rajatchaple/cubit_3.0/misc/lcd_screens_builder/cubit3/screen_images/about_image_saloni.png

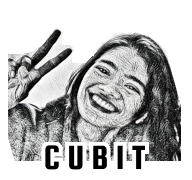
misc/lcd_screens_builder/cubit3/screen_images/about_image_saloni.png
