rajatchaple/cubit_3.0/challenges_faced/iCloud Photos/IMG_4615.JPEG

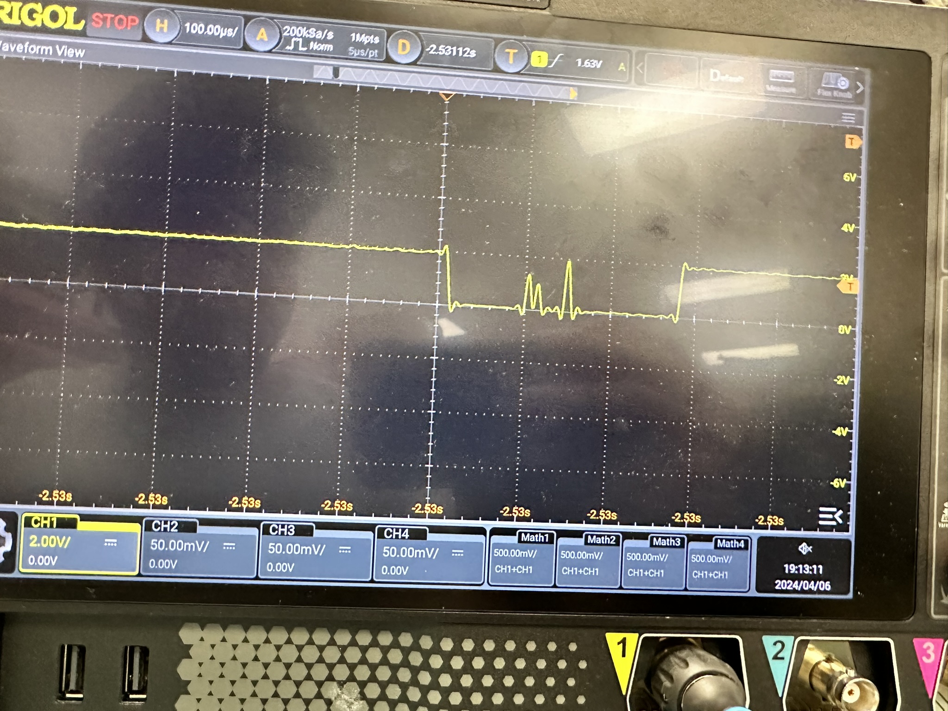
challenges_faced/iCloud Photos/IMG_4615.JPEG
