rajatchaple/cubit_3.0/software/imported_project_report.html

# Project Import Summary

Import time | Apr 2, 2024, 9:28:46 PM
Original location | C:\Users\rajat\OneDrive\Low Power\cubit2.0\lpedt_cubit_2.0\software\.cproject
Original project name | software
Original project type | Simplicity Studio (.sls)
Import mode | Copy contents
