rajatchaple/cubit_3.0/challenges_faced/iCloud Photos/IMG_4606.JPEG

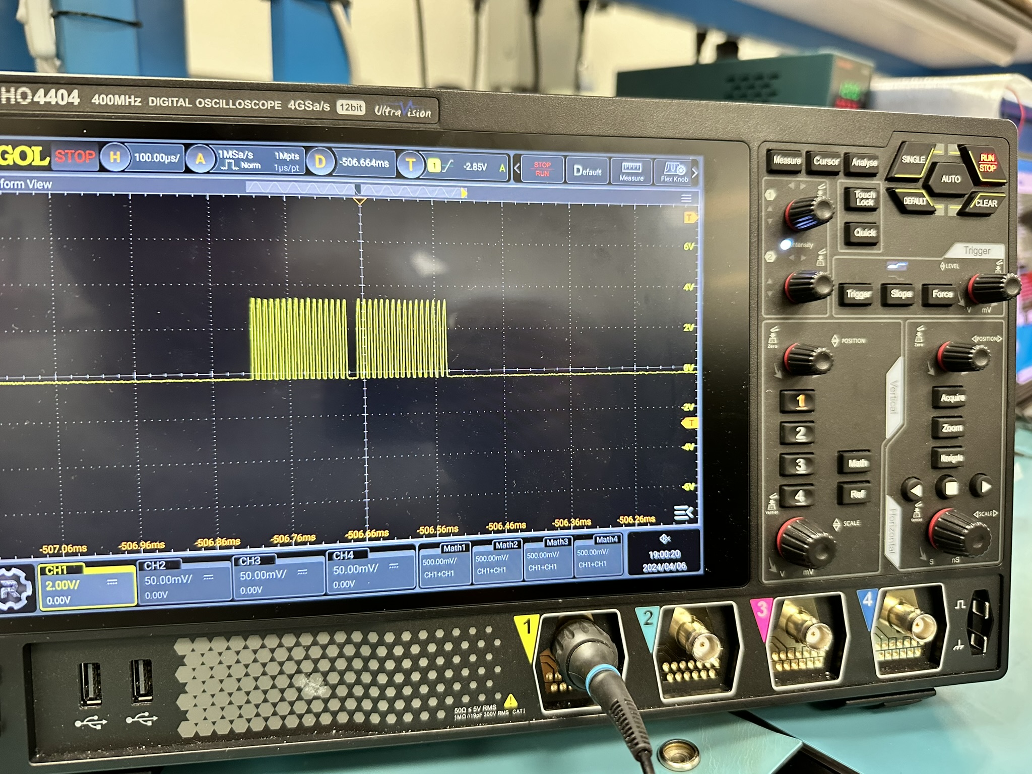
challenges_faced/iCloud Photos/IMG_4606.JPEG
