rajatchaple/cubit_3.0/challenges_faced/iCloud Photos/IMG_4608.JPEG

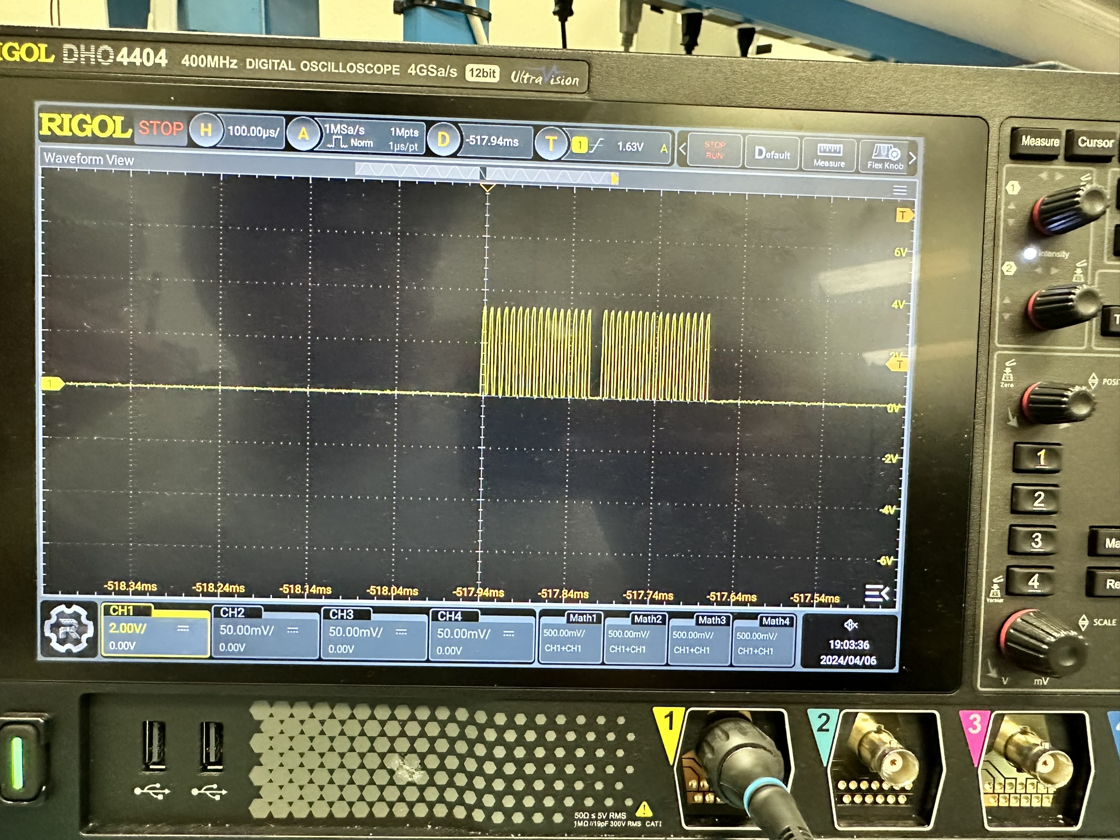
challenges_faced/iCloud Photos/IMG_4608.JPEG
