rajatchaple/cubit_3.0/challenges_faced/iCloud Photos/IMG_4609.JPEG

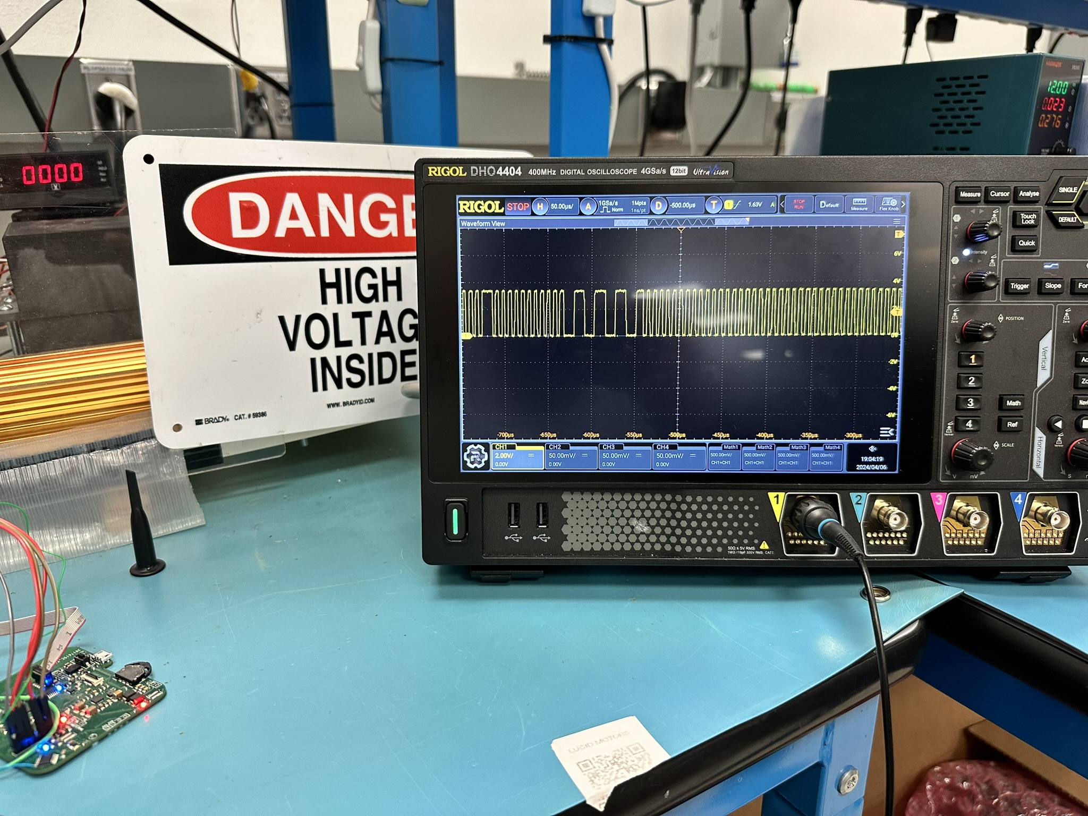
challenges_faced/iCloud Photos/IMG_4609.JPEG
