rajatchaple/cubit_3.0/challenges_faced/iCloud Photos/IMG_4610.JPEG

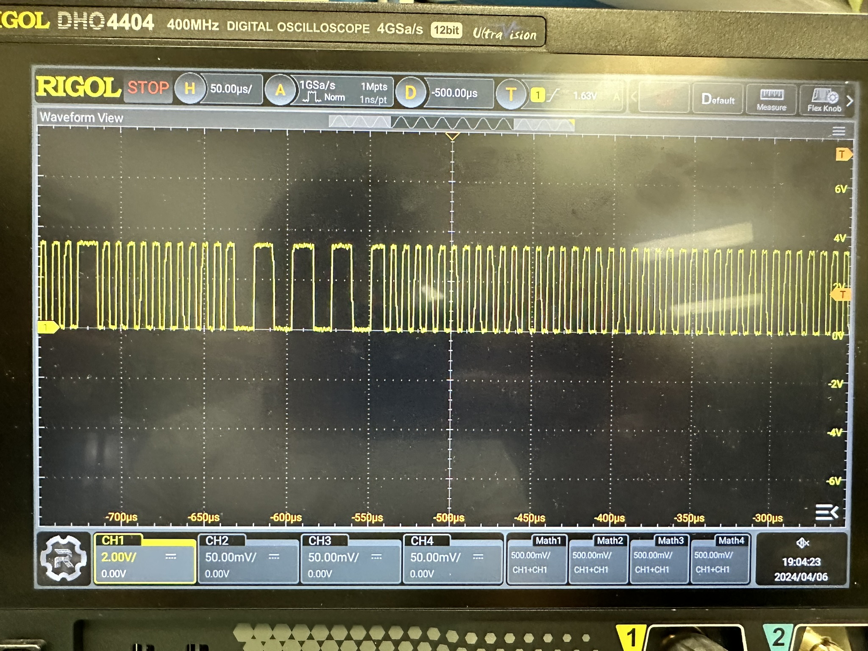
challenges_faced/iCloud Photos/IMG_4610.JPEG
