rajatchaple/cubit_3.0/pcb/components_list.pdf

Designator | Comment | Description | Footprint | Qty
C1, C14, C16, C17 | 1uF 25V | Cap 1 µF ±10% 25V Ceramic Capacitor X5R 0805 (2012 Metric) CAP_0805_02X125 | | 4
C2, C15, C20, C23, C29, C30, C31, C32, C36, C37, C40, C42 0.1uF 16V | | Cap Ceramic 0.1uF 16V X7R 10% SMD 0603 125°C Paper T/R CAP_0603_1MM | | 12
C3, C4, C5 | 1nF 50V | 1nF ±10% 50V X7R 0805 | CAP_0805_02X125 | 3
C6, C13, C18, C25, C33, C34, C35, C38, C39, C41 10uF 25V | | Cap 0805 25 V 10 uF ±20% Tolerance X5R Monolithic Ceramic Chip Capacitor CAP_0805_02X125 | | 10
C7 | 1.5pF 50V | Cap Ceramic 1.5pF 50V C0G 5% Pad SMD 0402 125C Automotive T/R CAP_0402_1mm | | 1
C8 | 100pF 50V | Cap 0.1nF ±10% 50V X7R 0805 CAP_0805_02X125 | | 1
C9, C11 | 10pF 50V | Cap Ceramic 10pF 50V X7R 10% SMD 0805 125°C Paper T/R CAP_0805_02X125 | | 2
C10 | 220nF 50V | Cap 220nF ±10% 50V X7R 0805 CAP_0805_02X125 | | 1
C12, C22, C26 | 4.7uF 10V | Cap CL10 Series 4.7 uF 10 V ±10 % Tolerance X5R SMT Multilayer Ceramic Capacitor CAP_0603_1MM | | 3
C19, C27 | 10nF 50V | Cap 10nF ±10% 50V X7R 0805 CAP_0805_02X125 | | 2
C21 | 220uF 6.3V | Cap 220uF 6.3volts X5R 20%Chip_1210_3.2x2.5 | | 1
C24, C28 | 100uF 10V | Cap 100uF ±20% 10V X5R 1210 Chip_1210_3.2x2.5 | | 2
D1, D2 | Schottky Diode | LSM115J Series 15 V 1 A Surface Mount Schottky Rectifier - DO-214BA SCHOTTKY4336X33N | | 2
H1 | Debug Port | CONN HEADER SMD 10POS 1.27MM. Connector Header Surface Mount 10 position 0.050" Amphenol_20021121_0 | | 1
H2 | Battery Connector | 2.00mm Pitch Mi ll System Wire-to-Board Header, Surface Mount, Single Row, Vertical, 2 Circuits BAT_CONN | | 1
H3 | USB MICRO B RECPT | USB - micro B USB 2.0 Receptacle Connector 5 Position Surface Mount, Right Angle; Through Hole MICROUSB_AMPHENOL_10118194-0001LF 1
H4 | PREC003SAAN-RC | Connector Header Through Hole 3 position 0.100" (2.54mm) 3_PIN_100mil | | 1
H5, H6 | External Power Connector | | 2_PIN_100mil | 2
H7 | SPI_MAG | | 6_PIN_100MIL | 1
H8 | Laser connector | 2.00mm Pitch | BAT_CONN | 1
L1, L2 | 1.9nH 1A | Inductor Chip 1.9nH 0.3nH Tolerance 2-Pin 0402 Paper T/R CAP_0402_1mm | | 2
L3, L4 | 600ohm 500mA | Ferrite Beads 0603 600Ω ±25% DCR=0.38Ω 500mA IND_FERRITE_0603_1.6x0.4 | | 2
L5 | 4.7uH 1.4A | 4.7uH, 20%, 1 Element, Metal Alloy-Core, SMD, 1008 INDP2523X23N_4u7 | | 1
L6 | 1k 200mA | Ferrite Beads WE-CBF 0603 SMD Bead 100MHz 1000Ohm 200mA CAP_0603_1MM | | 1
L7 | 22uH | Inductor Power Shielded Wirewound 22uH 20% 1MHz Ferrite 0.87A 0.496Ohm DCR 1212 T/R 2_IND_3x3 | | 1
L8 | 10uH 1A | Inductor Power Shielded Multi-Layer 10uH 20% 1MHz Metal 0.85A 0.46Ohm DCR 1008 T/R 2_chip_2.5x2 | | 1
LCD1 | 505110-1092_SHARP_LCDFFC/FPC Connector, 10 Contact(s), 1 Row(s), Female, Right Angle, Surface Mount Terminal SHARP_LCD | | | 1
LED4, LED10 | Green | Led Green Clear 0603 SMDLED_0603_RED_WL-SMCW | | 2
LED5, LED6, LED7, LED8 150060RS75000 | | LED Low-Power Uni-Color Red 630nm 2V 2-Pin Chip 0603(1608Metric) T/R LED_0603_RED_WL-SMCW | | 4
LED11, LED12 | 150060BS75000 | Led, Blue, 470 Nm, 3.2 V, 30 Ma, 145 Mcd Rohs Compliant: Yes LED_0603_RED_WL-SMCW | | 2
MH1, MH3, MH6, MH7, MH8, MH16 #4_Hole | | | HOLE_#4 | 6
R1, R7, R8 | 10k 1% | Res 10K Ohm 1% 1/10W ±100ppm/°C Molded SMD SMD Paper T/R 2_Chip_0603_RMCF | | 3
R2, R3, R5, R6 | 1M 1% | Res 1M Ohm 1% 1/10W ±100ppm/°C Molded SMD Paper T/R 2_Chip_0603_RMCF | | 4
R4, R18 | 100 1% | Res 100 Ohm 1% 1/10W ±100ppm/°C Molded SMD SMD Paper T/R 2_Chip_0603_RMCF | | 2
R10, R11 | 4.7k 1% | Res Thick Film 0603 4.7K Ohm 1% 1/10W ±100ppm/°C Molded SMD Paper T/R CAP_0603_1MM | | 2
R12, R13, R21 | 0 5% | Res 0 Ohms ±5% 0.063 W 0402 Thick Film Surface Mount Chip Resistor CAP_0402_1mm | | 3
R16, R26, R27, R31, R38 | 1k 1% | Res 1K Ohm 1% 0.1W(1/10W) ±100ppm/C Pad SMD Automotive T/R 2_Chip_0603_RMCF | | 5
R17, R25 | 1 1% | Res 1 Ohm 1% 1/10W ±200ppm/°C Molded SMD SMD Paper T/R CAP_0603_1MM | | 2
R19 | 10M 1% | Res 10M Ohm 1% 1/10W ±200ppm/°C Molded SMD SMD Paper T/R 2_Chip_0603_RMCF | | 1
R20 | 2M 1% | RES 2M OHM 1% 1/10W 0603 2_Chip_0603_RMCF | | 1
R22 | 7.87M 1% | Res 7.87M Ohm 1% 1/10W ±200ppm/°C Molded SMD SMD Paper T/R 2_Chip_0603_RMCF | | 1
R23 | 20 1% | Res High Voltage 0603 20 Ohm 1/10W 1% SMD 2_Chip_0603_RMCF | | 1
R28, R33 | 7.32M 1% | Res 7.32M Ohm 1% 1/10W ±200ppm/°C Molded SMD SMD Paper T/R 2_Chip_0603_RMCF | | 2

Designator | Comment | Description | Footprint | Qty
R29 | 1.43M 1% | Res 1.43M Ohm 1% 1/10W ±200ppm/°C Molded SMD SMD Paper T/R 2_Chip_0603_RMCF | | 1
R30 | 8.06M 1% | Res 8.06M Ohm 1% 1/10W ±200ppm/°C Molded SMD SMD Paper T/R 2_Chip_0603_RMCF | | 1
R32 | 5.62M 1% | Res 5.62M Ohm 1% 1/10W ±200ppm/°C Molded SMD SMD Paper T/R 2_Chip_0603_RMCF | | 1
R34 | 4.87M 1% | Res 4.87M Ohm 1% 1/10W ±200ppm/°C Molded SMD SMD Paper T/R 2_Chip_0603_RMCF | | 1
R35 | 3k 1% | Res 3000Ω ± 1.00% 0.1W ± 100ppm/ CAP_0603_1MM | | 1
R36 | 4.42M 1% | Res 4.42M Ohm 1% 1/10W ±200ppm/°C Molded SMD SMD Paper T/R 2_Chip_0603_RMCF | | 1
R40, R42 | 3kohm | Res 3000Ω ± 1.00% 0.1W ± 100ppm/ CAP_0603_1MM | | 2
S1, S2, S3, S4, S5, S6, S7, S8, S9, S10 Solar Cell | | Monocrystalline SOLAR CELL 30.7MW 690MV KXOB25-14X1F | | 10
SW1 | COM-08184 | Surface Mount Navigation Switch Navigation_switch | | 1
SW2 | Switch | Keypad Switch, 1 Switches, SPST, Momentary-tactile, 0.05A, 12VDC, 1.77N, Solder Terminal, Surface Mount-straight Reset Sw | | 1
TP6 | 3_pin_test | | 3_PIN_100mil | 1
U1 | Analog Switch | SPDT, 2 Func, 2 Channel, PDSO10 TSSOP50P490X110-10N | | 1
U2, U8, U12, U13 | Load SW | 5.5-V, 0.1-A, 500-mΩ, load switch with current limit and active low enable 5-SC70 -40 to 85 SOT65P210X110-5N | | 4
U3 | EFR32BG13 | Blue Gecko QFN48 2.4 G 19 dB BLE/Proprietary 512 kB 64 kB(RAM) 31GPIO 48-QFN_7x7 | | 1
U4, U5 | ESD-SP1003 | TVS DIODE 5VWM 12VC SOD723 Littelfuse_Inc_SP1003_MFG | | 2
U6 | BQ25570 | Switching Battery Charger Li-Ion/Li-Pol/Supercapacitor 110mA 2.2V to 5.5V 20-Pin VQFN EP T/R 21_QFN_35x35 | | 1
U7 | Ultrasonic Sensor | | 4_PIN_ultrasonic_sensor | 1
U9 | BNO005 | | LGA28R50P4X10_380X520X100 1
U10, U11 | AS5047D-ATSM | | 14-TSOP_5x4_4 | 2
U14 | BATT Monitor IC | Battery Battery Monitor IC Lithium-Ion 8-TDFN-EP ( MAX17048 | | 1
X1 | 38.4MHz | Crystal 38.4000MHZ 10PF SMD OSC_38.4MHz | | 1
Y1 | ECS-.327-7-34B-TR | 32.768kHz Â±20ppm Crystal 7pF 70 kOhms 2-SMD, No Lead XTAL_ECS-.327-7-34B-TR | | 1
