rajatchaple/cubit_3.0/pcb/BOM_cubit2.xlsx

Comment | Description | Designator | Footprint | LibRef | Quantity | Case/Package | Manufacturer | Manufacturer Part Number | Supplier 1
1uF 25V | Cap 1 µF ±10% 25V Ceramic Capacitor X5R 0805 (2012 Metric) | C1, C14, C16, C17 | CAP_0805_02X125 | GRM216R61E105KA12D | 4 | 0805 | Murata | GRM216R61E105KA12D | Digi-Key
0.1uF 16V | Cap Ceramic 0.1uF 16V X7R 10% SMD 0603 125°C Paper T/R | C2, C15, C20, C23, C29, C30, C31, C32, C36, C37, C40, C42 | CAP_0603_1MM | C0805C104K4RACAUTO | 12 | 0805 | KEMET | C0805C104K4RACAUTO | Digi-Key
1nF 50V | 1nF ±10% 50V X7R 0805 | C3, C4, C5 | CAP_0805_02X125 | CL21B102KBANFNC | 3 | 0805 | Samsung | CL21B102KBANFNC | Digi-Key
10uF 25V | Cap 0805 25 V 10 uF ±20% Tolerance X5R Monolithic Ceramic Chip Capacitor | C6, C13, C18, C25, C33, C34, C35, C38, C39, C41 | CAP_0805_02X125 | GRM21BR61E106KA73K | 10 | 0805 | Murata | GRM21BR61E106KA73K | Digi-Key
1.5pF 50V | Cap Ceramic 1.5pF 50V C0G 5% Pad SMD 0402 125C Automotive T/R | C7 | CAP_0402_1mm | GCM1555C1H1R5JA16D | 1 | 0402 | Murata | GCM1555C1H1R5JA16D | Digi-Key
100pF 50V | Cap 0.1nF ±10% 50V X7R 0805 | C8 | CAP_0805_02X125 | CC0805KRX7R9BB101 | 1 | 0805 | Yageo | CC0805KRX7R9BB101 | Digi-Key
10pF 50V | Cap Ceramic 10pF 50V X7R 10% SMD 0805 125°C Paper T/R | C9, C11 | CAP_0805_02X125 | C0805C100K5RACTU | 2 | 0805 | KEMET | C0805C100K5RACTU | Digi-Key
220nF 50V | Cap 220nF ±10% 50V X7R 0805 | C10 | CAP_0805_02X125 | CC0805KKX7R9BB224 | 1 | 0805 | Yageo | CC0805KKX7R9BB224 | Digi-Key
4.7uF 10V | Cap CL10 Series 4.7 uF 10 V ±10 % Tolerance X5R SMT Multilayer Ceramic Capacitor | C12, C22, C26 | CAP_0603_1MM | CL10A475KP8NNNC | 3 | 0603 | Samsung | CL10A475KP8NNNC | Digi-Key
10nF 50V | Cap 10nF ±10% 50V X7R 0805 | C19, C27 | CAP_0805_02X125 | CL21B103KBCNNNC | 2 | 0805 | Samsung | CL21B103KBCNNNC | Digi-Key
220uF 6.3V | Cap 220uF 6.3volts X5R 20% | C21 | Chip_1210_3.2x2.5 | GRM32ER60J227ME05L | 1 |  | Murata | GRM32ER60J227ME05L | Digi-Key
100uF 10V | Cap 100uF ±20% 10V X5R 1210 | C24, C28 | Chip_1210_3.2x2.5 | CL32A107MPVNNNE | 2 | 1210 | Samsung | CL32A107MPVNNNE | Digi-Key
Schottky Diode | LSM115J Series 15 V 1 A Surface Mount Schottky Rectifier - DO-214BA | D1, D2 | SCHOTTKY4336X33N | LSM115JE3/TR13 | 2 |  | Microchip | LSM115JE3/TR13 | Digi-Key
Debug Port | CONN HEADER SMD 10POS 1.27MM. Connector Header Surface Mount 10 position 0.050" | H1 | Amphenol_20021121_0 | 20021121-00010C1LF | 1 |  | Amphenol ICC / FCI | 20021121-00010C1LF | Digi-Key
Battery Connector | 2.00mm Pitch Mi ll System Wire-to-Board Header, Surface Mount, Single Row, Vertical, 2 Circuits | H2 | BAT_CONN | 0554600272 | 1 |  | Molex | 0554600272 | Digi-Key
USB MICRO B RECPT | USB - micro B USB 2.0 Receptacle Connector 5 Position Surface Mount, Right Angle; Through Hole | H3 | MICROUSB_AMPHENOL_10118194-0001LF | 10118194-0001LF | 1 |  | Amphenol FCI | 10118194-0001LF | Digi-Key
PREC003SAAN-RC | Connector Header Through Hole 3 position 0.100" (2.54mm) | H4 | 3_PIN_100mil | SW_3Pin_100mil_Switch | 1
External Power Connector |  | H5, H6 | 2_PIN_100mil | ext_pwr_conn | 2
SPI_MAG |  | H7 | 6_PIN_100MIL | 6_pin_connector | 1
Laser connector | 2.00mm Pitch | H8 | BAT_CONN | batt_conn_pad | 1
1.9nH 1A | Inductor Chip 1.9nH 0.3nH Tolerance 2-Pin 0402 Paper T/R | L1, L2 | CAP_0402_1mm | LQG15WZ1N9S02D | 2 |  | Murata | LQG15WZ1N9S02D | Digi-Key
600ohm 500mA | Ferrite Beads 0603 600Ω ±25% DCR=0.38Ω 500mA | L3, L4 | IND_FERRITE_0603_1.6x0.4 | BLM18AG601SN1D | 2 | 0603 | Murata | BLM18AG601SN1D | Digi-Key
4.7uH 1.4A | 4.7uH, 20%, 1 Element, Metal Alloy-Core, SMD, 1008 | L5 | INDP2523X23N_4u7 | DFE252012P-4R7M=P2 | 1 |  | Murata | DFE252012P-4R7M=P2 | Digikey
1k 200mA | Ferrite Beads WE-CBF 0603 SMD Bead 100MHz 1000Ohm 200mA | L6 | CAP_0603_1MM | 74279266 | 1 | SMD/SMT | Wurth Electronics | 74279266 | Digi-Key
22uH | Inductor Power Shielded Wirewound 22uH 20% 1MHz Ferrite 0.87A 0.496Ohm DCR 1212 T/R | L7 | 2_IND_3x3 | VLS3015CX-220M-1 | 1 |  | TDK | VLS3015CX-220M-1 | Digi-Key
10uH 1A | Inductor Power Shielded Multi-Layer 10uH 20% 1MHz Metal 0.85A 0.46Ohm DCR 1008 T/R | L8 | 2_chip_2.5x2 | 1239AS-H-100M=P2 | 1 | 1008 | Murata | 1239AS-H-100M=P2 | Digi-Key
505110-1092_SHARP_LCD | FFC/FPC Connector, 10 Contact(s), 1 Row(s), Female, Right Angle, Surface Mount Terminal | LCD1 | SHARP_LCD | 505110-1092_SHARP_LCD | 1 |  | Molex | 505110-1092 | Digi-Key
Green | Led Green Clear 0603 SMD | LED4, LED10 | LED_0603_RED_WL-SMCW | QBLP601-AG1 | 2 |  | QT-Brightek | QBLP601-AG1 | Digi-Key
150060RS75000 | LED Low-Power Uni-Color Red 630nm 2V 2-Pin Chip 0603(1608Metric) T/R | LED5, LED6, LED7, LED8 | LED_0603_RED_WL-SMCW | 150060RS75000 | 4 | 0603 | Wurth Electronics | 150060RS75000 | Digi-Key
150060BS75000 | Led, Blue, 470 Nm, 3.2 V, 30 Ma, 145 Mcd Rohs Compliant: Yes | LED11, LED12 | LED_0603_RED_WL-SMCW | 150060BS75000 | 2 | 0603 | Wurth Electronics | 150060BS75000 | Digi-Key
#4_Hole |  | MH1, MH3, MH6, MH7, MH8, MH16 | HOLE_#4 | Mechanical_Hole | 6
10k 1% | Res 10K Ohm 1% 1/10W ±100ppm/°C Molded SMD SMD Paper T/R | R1, R7, R8 | 2_Chip_0603_RMCF | RMCF0603FT10K0 | 3 | 0603 | Stackpole Electronics | RMCF0603FT10K0 | Digi-Key
1M 1% | Res 1M Ohm 1% 1/10W ±100ppm/°C Molded SMD Paper T/R | R2, R3, R5, R6 | 2_Chip_0603_RMCF | RMCF0603FT1M00 | 4 | 0603 | Stackpole Electronics | RMCF0603FT1M00 | Digi-Key
100 1% | Res 100 Ohm 1% 1/10W ±100ppm/°C Molded SMD SMD Paper T/R | R4, R18 | 2_Chip_0603_RMCF | RMCF0603FT100R | 2 | 0603 | Stackpole Electronics | RMCF0603FT100R | Digi-Key
4.7k 1% | Res Thick Film 0603 4.7K Ohm 1% 1/10W ±100ppm/°C Molded SMD Paper T/R | R10, R11 | CAP_0603_1MM | AF0603FR-074K7L | 2 | 0603 | Yageo | AF0603FR-074K7L | Digi-Key
0 5% | Res 0 Ohms ±5% 0.063 W 0402 Thick Film Surface Mount Chip Resistor | R12, R13, R21 | CAP_0402_1mm | RC1005J000CS | 3 | 0402 | Samsung | RC1005J000CS | Digi-Key
1k 1% | Res 1K Ohm 1% 0.1W(1/10W) ±100ppm/C Pad SMD Automotive T/R | R16, R26, R27, R31, R38 | 2_Chip_0603_RMCF | RMCF0603FT1K00 | 5 | 0603 | Stackpole Electronics | RMCF0603FT1K00 | Digi-Key
1 1% | Res 1 Ohm 1% 1/10W ±200ppm/°C Molded SMD SMD Paper T/R | R17, R25 | CAP_0603_1MM | RC0603FR-101RL | 2 | 0603 | Yageo | RC0603FR-101RL | Digi-Key
10M 1% | Res 10M Ohm 1% 1/10W ±200ppm/°C Molded SMD SMD Paper T/R | R19 | 2_Chip_0603_RMCF | RMCF0603FT10M0 | 1 | 0603 | Stackpole Electronics | RMCF0603FT10M0 | Digi-Key
2M 1% | RES 2M OHM 1% 1/10W 0603 | R20 | 2_Chip_0603_RMCF | RMCF0603FT2M00 | 1 | 0603 | Stackpole Electronics | RMCF0603FT2M00 | Digi-Key
7.87M 1% | Res 7.87M Ohm 1% 1/10W ±200ppm/°C Molded SMD SMD Paper T/R | R22 | 2_Chip_0603_RMCF | RMCF0603FT7M87 | 1 | 0603 | Stackpole Electronics | RMCF0603FT7M87 | Digi-Key
20 1% | Res High Voltage 0603 20 Ohm 1/10W 1% SMD | R23 | 2_Chip_0603_RMCF | KTR03EZPF20R0 | 1 | 0603 | Rohm | KTR03EZPF20R0 | Digi-Key
7.32M 1% | Res 7.32M Ohm 1% 1/10W ±200ppm/°C Molded SMD SMD Paper T/R | R28, R33 | 2_Chip_0603_RMCF | RMCF0603FT7M32 | 2 | 0603 | Stackpole Electronics | RMCF0603FT7M32 | Digi-Key
1.43M 1% | Res 1.43M Ohm 1% 1/10W ±200ppm/°C Molded SMD SMD Paper T/R | R29 | 2_Chip_0603_RMCF | RMCF0603FT1M43 | 1 | 0603 | Stackpole Electronics | RMCF0603FT1M43 | Digi-Key
8.06M 1% | Res 8.06M Ohm 1% 1/10W ±200ppm/°C Molded SMD SMD Paper T/R | R30 | 2_Chip_0603_RMCF | RMCF0603FT8M06 | 1 | 0603 | Stackpole Electronics | RMCF0603FT8M06 | Digi-Key
5.62M 1% | Res 5.62M Ohm 1% 1/10W ±200ppm/°C Molded SMD SMD Paper T/R | R32 | 2_Chip_0603_RMCF | RMCF0603FT5M62 | 1 | 0603 | Stackpole Electronics | RMCF0603FT5M62 | Digi-Key
4.87M 1% | Res 4.87M Ohm 1% 1/10W ±200ppm/°C Molded SMD SMD Paper T/R | R34 | 2_Chip_0603_RMCF | RMCF0603FT4M87 | 1 | 0603 | Stackpole Electronics | RMCF0603FT4M87 | Digi-Key
3k 1% | Res 3000Ω ± 1.00% 0.1W ± 100ppm/℃ 0603 | R35 | CAP_0603_1MM | RC0603FR-073KL | 1 | 0603 | Yageo | RC0603FR-073KL | Digi-Key
4.42M 1% | Res 4.42M Ohm 1% 1/10W ±200ppm/°C Molded SMD SMD Paper T/R | R36 | 2_Chip_0603_RMCF | RMCF0603FT4M42 | 1 | 0603 | Stackpole Electronics | RMCF0603FT4M42 | Digi-Key
3kohm | Res 3000Ω ± 1.00% 0.1W ± 100ppm/℃ 0603 | R40, R42 | CAP_0603_1MM | RC0603FR-073KL | 2 | 0603 | Yageo | RC0603FR-073KL | Digi-Key
Solar Cell | Monocrystalline SOLAR CELL 30.7MW 690MV | S1, S2, S3, S4, S5, S6, S7, S8, S9, S10 | KXOB25-14X1F | KXOB25-14X1F | 10 |  | ANYSOLAR | KXOB25-14X1F-TR | Digikey
COM-08184 | Surface Mount Navigation Switch | SW1 | Navigation_switch | COM-08184 | 1 |  | SparkFun | COM-08184 | Digikey
Switch | Keypad Switch, 1 Switches, SPST, Momentary-tactile, 0.05A, 12VDC, 1.77N, Solder Terminal, Surface Mount-straight | SW2 | Reset Sw | PTS636SL43SMTRLFS | 1 |  | ITT C&K | PTS636SL43SMTRLFS | Digikey
3_pin_test |  | TP6 | 3_PIN_100mil | 3_pin_test | 1
Analog Switch | SPDT, 2 Func, 2 Channel, PDSO10 | U1 | TSSOP50P490X110-10N | TS3A24159DGSR | 1 |  | Texas Instruments | TS3A24159DGSR | Digikey
Load SW | 5.5-V, 0.1-A, 500-mΩ, load switch with current limit and active low enable 5-SC70 -40 to 85 | U2, U8, U12, U13 | SOT65P210X110-5N | TPS22942DCKR | 4 | SC | Texas Instruments | TPS22942DCKR | Digi-Key
EFR32BG13 | Blue Gecko QFN48 2.4 G 19 dB BLE/Proprietary 512 kB 64 kB(RAM) 31GPIO | U3 | 48-QFN_7x7 | EFR32BG13P732F512GM48-D | 1 |  | Silicon Labs | EFR32BG13P732F512GM48-D | Digi-Key
ESD-SP1003 | TVS DIODE 5VWM 12VC SOD723 | U4, U5 | Littelfuse_Inc_SP1003_MFG | SP1003-01DTG | 2 |  | Littelfuse | SP1003-01DTG | Digi-Key
BQ25570 | Switching Battery Charger Li-Ion/Li-Pol/Supercapacitor 110mA 2.2V to 5.5V 20-Pin VQFN EP T/R | U6 | 21_QFN_35x35 | BQ25570RGRT | 1 | VQFN | Texas Instruments | BQ25570RGRT | Digi-Key
Ultrasonic Sensor |  | U7 | 4_PIN_ultrasonic_sensor | Ultrasonic Sensor | 1
BNO005 |  | U9 | LGA28R50P4X10_380X520X100 | BNO055 | 1
AS5047D-ATSM |  | U10, U11 | 14-TSOP_5x4_4 | AS5047D-ATSM | 2 |  | Osram | AS5047D-ATSM | Digi-Key
BATT Monitor IC | Battery Battery Monitor IC Lithium-Ion 8-TDFN-EP ( | U14 | MAX17048 | MAX17048G+T10 | 1 |  | Maxim | MAX17048G+T10 | Digikey
38.4MHz | Crystal 38.4000MHZ 10PF SMD | X1 | OSC_38.4MHz | RH100-38.400-10-F-1010-TR | 1 |  | Raltron Electronics | RH100-38.400-10-F-1010-TR | Digi-Key
ECS-.327-7-34B-TR | 32.768kHz Â±20ppm Crystal 7pF 70 kOhms 2-SMD, No Lead | Y1 | XTAL_ECS-.327-7-34B-TR | ECS-.327-7-34B-TR | 1
