rajatchaple/cubit_3.0/pcb_library/Component_Library.xlsx

Sheet: Sheet1
Part Description | Part Number | Part Value/Notes | Footprint Name | Footprint description | Datasheet Link | Online SnapEDA/Octopart Link
Blue Gecko | EFR32BG13P732F512GM48-D | Blue Gecko QFN48 2.4 G 19 dB BLE/Proprietary 512 kB 64 kB(RAM) 31GPIO | 48-QFN_7x7 | QFN, 48-Leads, Body 7.00x7.00mm, Pitch 0.50mm, Thermal Pad 4.70x4.70mm, IPC Medium Density | EFR32BG13 Data Sheet: Blue Gecko Bluetooth® Low Energy SoC Family (silabs.com) (https://www.silabs.com/documents/public/data-sheets/efr32bg13-datasheet.pdf)
PMIC | BQ25570RGRT | Ultra Low power Harvester power Management IC with boost charger, and Nanopower Buck Converter 20-VQFN -40 to 125 | 21_QFN_35X35 |  | bq25570 nano power boost charger and buck converter for energy harvester powered applications datasheet (Rev. G) (https://www.ti.com/lit/ds/symlink/bq25570.pdf) | BQ25570RGRT footprint & symbol by Texas Instruments | SnapEDA (https://www.snapeda.com/parts/BQ25570RGRT/Texas%20Instruments/view-part/?t=bq25570&welcome=home)
IMU Sensor | BNO055 |  | LGA28R50P4X10_380X520X100 |  | datasheet.pdf (itisfermi.edu.it) (https://www.itisfermi.edu.it/enforce/2017/pdf/bno055/datasheet.pdf) | BNO055 footprint & symbol by Bosch Sensortec | SnapEDA (https://www.snapeda.com/parts/BNO055/Bosch%20Sensortec/view-part/)
 |  |  |  |  | BNO055 Datasheet (bosch-sensortec.com) (https://www.bosch-sensortec.com/media/boschsensortec/downloads/datasheets/bst-bno055-ds000.pdf)
Magnetic Encoder | AS5147P-HTSM | Rotary Position Sensor 5.5V/3.6V Digital Output Automotive 14-Pin TSSOP T/R | 14-TSOP_5x4_4 | TSOP, 14-Leads, Body 5.00x4.40mm, Pitch 0.65mm, IPC Medium Density | AS5147P_DS000328_2-00.pdf (ams.com) (https://ams.com/documents/20143/36005/AS5147P_DS000328_2-00.pdf)
Resistor | RMCF0603FT1K00 | Res Thick Film 0603 1K Ohm 1% 0.1W(1/10W) ±100ppm/C Pad SMD Automotive T/R | 2_Chip_0603_RMCF |  | sei-rmcf_rmcp.pdf (seielect.com) (https://www.seielect.com/catalog/sei-rmcf_rmcp.pdf)
Capacitor | CL10A475KP8NNNC | CL10 Series 4.7 uF 10 V ±10 % Tolerance X5R SMT Multilayer Ceramic Capacitor | CAP_0603_1MM | Chip Capacitor, 2-Leads, Body 1.60x0.80mm, IPC Medium Density | CL10A475KP8NNNC_Spec.pdf (digikey.com) (https://media.digikey.com/pdf/Data%20Sheets/Samsung%20PDFs/CL10A475KP8NNNC_Spec.pdf)
Inductor | VLS3015CX-220M-1 | Inductor Power Shielded Wirewound 22uH 20% 1MHz Ferrite 0.87A | 2_IND_3x3 |  | Inductors for power circuits Wound ferrite VLS-CX-1 series (tdk.com) (https://product.tdk.com/en/system/files)
LED (red) | 150060RS75000 | LED Low-Power Uni-Color Red 630nm 2V 2-Pin Chip 0603(1608Metric) T/R | LED_0603_RED_WL-SMCW | SODFL, 2-Leads, Body 0.80x1.80mm, IPC Medium Density | https://datasheet.ciiva.com/29563/150060rs75000-29563040.pdf?src-supplier=Digi-Key
LCD header | 3502 | Conn AV RCA (Phono) Plug 2 Cont Sz 0.125" Cbl Mnt Clamp Copper Alloy | LCD_SHARP_MEMORY_9_PIN |  | https://cdn-learn.adafruit.com/downloads/pdf/adafruit-sharp-memory-display-breakout.pdf?src-supplier=Digi-Key
Ultrasonic sensor | 982 |  |  |  | 982 Adafruit Industries LLC | Sensors, Transducers | DigiKey (https://www.digikey.com/en/products/detail/adafruit-industries-llc/982/5356850)

Sheet: Schematic
EFR32 Radio Interface |  |  |  | Added by
BLM18AG601SN1 | 600 Ohms @ 100 MHz 1 - Ferrite Bead 0603 (1608 Metric) 500mA 380mOhm | BLM18AG601SN1D Murata Electronics | Filters | DigiKey (https://www.digikey.com/en/products/detail/murata-electronics/BLM18AG601SN1D/584225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) | ENFA0003.pdf (murata.com) (https://www.murata.com/en-us/products/productdata/8796738650142/ENFA0003.pdf) | Saloni
100pF | 100 pF ±10% 50V Ceramic Capacitor X7R 0805 (2012 Metric) | CC0805KRX7R9BB101 YAGEO | Capacitors | DigiKey (https://www.digikey.com/en/products/detail/yageo/CC0805KRX7R9BB101/5884228) | UPY-GPHC_X7R_6.3V-to-50V_20.pdf (yageo.com) (https://www.yageo.com/upload/media/product/productsearch/datasheet/mlcc/UPY-GPHC_X7R_6.3V-to-50V_20.pdf) | Saloni
10pF | 10 pF ±10% 50V Ceramic Capacitor X7R 0805 (2012 Metric) | C0805C100K5RAC7800 KEMET | Capacitors | DigiKey (https://www.digikey.com/en/products/detail/kemet/C0805C100K5RAC7800/8572447) | KEM_C1002_X7R_SMD.pdf (kemet.com) (https://content.kemet.com/datasheets/KEM_C1002_X7R_SMD.pdf) | Saloni
220nF | 0.22 µF ±10% 50V Ceramic Capacitor X7R 0805 (2012 Metric) | CC0805KKX7R9BB224 YAGEO | Capacitors | DigiKey (https://www.digikey.com/en/products/detail/yageo/CC0805KKX7R9BB224/5195293) | UPY-GPHC_X7R_6.3V-to-50V_20.pdf (yageo.com) (https://www.yageo.com/upload/media/product/productsearch/datasheet/mlcc/UPY-GPHC_X7R_6.3V-to-50V_20.pdf) | Saloni
1N9 | 1.9 nH Unshielded Multilayer Inductor 1 A 50mOhm Max 0402 (1005 Metric) - | LQG15WZ1N9S02D Murata Electronics | Inductors, Coils, Chokes | DigiKey (https://www.digikey.com/en/products/detail/murata-electronics/LQG15WZ1N9S02D/11690275) | JELF243B-9117.pdf (murata.co.jp) (https://search.murata.co.jp/Ceramy/image/img/P02/JELF243B-9117.pdf) | Saloni
1.5pF | 1.5 pF ±5% 50V Ceramic Capacitor C0G, NP0 0402 (1005 Metric) | GCM1555C1H1R5JA16D Murata Electronics | Capacitors | DigiKey (https://www.digikey.com/en/products/detail/murata-electronics/GCM1555C1H1R5JA16D/7363196) | GCM1555C1H1R5JA16-01.pdf (murata.co.jp) (https://search.murata.co.jp/Ceramy/image/img/A01X/G101/ENG/GCM1555C1H1R5JA16-01.pdf) | Saloni
0 ohm | 0 Ohms Jumper 0.063W, 1/16W Chip Resistor 0402 (1005 Metric) Moisture Resistant Thick Film | RC1005J000CS Samsung Electro-Mechanics | Resistors | DigiKey (https://www.digikey.com/en/products/detail/samsung-electro-mechanics/RC1005J000CS/3903488) | Microsoft PowerPoint - #1 RC_DataSheet_(150508).pptx (digikey.com) (https://media.digikey.com/pdf/Data%20Sheets/Samsung%20PDFs/RC_Series_ds.pdf) | Saloni
38.4MHz crystal
F_antenna
EFR32 Decoupling
1uF | 1 µF ±10% 25V Ceramic Capacitor X5R 0805 (2012 Metric) | GRM216R61E105KA12D Murata Electronics | Capacitors | DigiKey (https://www.digikey.com/en/products/detail/murata-electronics/GRM216R61E105KA12D/586873) | https://www.murata.com/-/media/webrenewal/support/library/catalog/products/capacitor/ceramiccapacitor/c02e.ashx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 | Rajat
Ferrite bead | 1 kOhms @ 100 MHz 1 Signal Line Ferrite Bead 0603 (1608 Metric) 200mA 600mOhm | 74279266 Würth Elektronik | Filters | DigiKey (https://www.digikey.com/en/products/detail/w%C3%BCrth-elektronik/74279266/3907315) | 74279266 Datasheet WE-CBF SMT EMI Suppression Ferrite Bead (we-online.com) (https://www.we-online.com/katalog/datasheet/74279266.pdf) | Saloni
1 ohm | 1 Ohms ±1% 0.1W, 1/10W Chip Resistor 0603 (1608 Metric) Thick Film | RC0603FR-101RL YAGEO | Resistors | DigiKey (https://www.digikey.com/en/products/detail/yageo/RC0603FR-101RL/14286393) | PYu-RC_Group_51_RoHS_L_11.pdf (yageo.com) (https://www.yageo.com/upload/media/product/productsearch/datasheet/rchip/PYu-RC_Group_51_RoHS_L_11.pdf) | Saloni
4.7uH | FIXED IND 4.7UH 1.2A 186MOHM SMD | LQH32PH4R7NNCL Murata Electronics | Inductors, Coils, Chokes | DigiKey (https://www.digikey.com/en/products/detail/murata-electronics/LQH32PH4R7NNCL/6799435) | JELF243A-9135.pdf (murata.co.jp) (https://search.murata.co.jp/Ceramy/image/img/P02/JELF243A-9135.pdf) | Rajat
0.1uF | CAP CER 0.1UF 16V X7R 0805 | C0805C104K4RACAUTO KEMET | Capacitors | DigiKey (https://www.digikey.com/en/products/detail/kemet/C0805C104K4RACAUTO/10642389) | https://api.kemet.com/component-edge/download/datasheet/C0805C104K4RACAUTO.pdf | Rajat
4.7uF | CL10 Series 4.7 uF 10 V ±10 % Tolerance X5R SMT Multilayer Ceramic Capacitor | CL10A475KP8NNNC Samsung Electro-Mechanics | Capacitors | DigiKey (https://www.digikey.com/en/products/detail/samsung-electro-mechanics/CL10A475KP8NNNC/3886702) | CL10A475KP8NNNC_Spec.pdf (digikey.com) (https://media.digikey.com/pdf/Data%20Sheets/Samsung%20PDFs/CL10A475KP8NNNC_Spec.pdf) | Rajat
IMU Sensor
22pF | CAP CER SMD 0805 22PF 10% 50V X7 | C0805C220K5RACAUTO KEMET | Capacitors | DigiKey (https://www.digikey.com/en/products/detail/kemet/C0805C220K5RACAUTO/8572462) | https://api.kemet.com/component-edge/download/datasheet/C0805C220K5RACAUTO.pdf | Rajat
10k | RES 10K OHM 1% 1/10W 0603 | RMCF0603FT10K0 Stackpole Electronics Inc | Resistors | DigiKey (https://www.digikey.com/en/products/detail/stackpole-electronics-inc/RMCF0603FT10K0/1761235) | sei-rmcf_rmcp.pdf (seielect.com) (https://www.seielect.com/catalog/sei-rmcf_rmcp.pdf) | Rajat

Sheet: BQ25570
Pin Name | Designator | Description
EN | 5 | Active low digital programming input for enabling/disabling the IC. Connect to GND to enable the IC.
LBOOST | 20 | Inductor connection for the boost charger switching node. Connect a 22 μH inductor between this pin and pin 2 (VIN_DC).
LBUCK | 16 | Inductor connection for the buck converter switching node. Connect at least a 4.7 μH inductor between this pin and pin 14 (VOUT).
NC | 9 | Connect to ground using the IC's PowerPAD™.
NC | 17 | Connect to ground using the IC's PowerPAD.
OK_HYST | 10 | Connect to the mid-point of external resistor divider between VRDIV and GND for setting the VBAT_OK hystersis threshold. If not used, connect this pin to GND.
OK_PROG | 11 | Connect to the mid-point of external resistor divider between VRDIV and GND for setting the VBAT_OK threshold. If not used, connect this pin to GND.
VBAT | 18 | Connect a rechargeable storage element with at least 100uF of equivalent capacitance between this pin and either VSS pin.
VBAT_OK | 13 | Digital output for battery good indicator. Internally referenced to the VSTOR voltage. Leave floating if not used.
VBAT_OV | 7 | Connect to the mid-point of external resistor divider between VRDIV and GND for setting the VBAT overvoltage threshold.
VIN_DC | 2 | DC voltage input from energy harvesting source. Connect at least a 4.7 μF capacitor as close as possible between this pin and pin 1.
VOC_SAMP | 3 | Sampling pin for MPPT network. Connect to VSTOR to sample at 80% of input source open circuit voltage. Connect to GND for 50% or connect to the mid-point of external resistor divider between VIN_DC and GND.
VOUT | 14 | Buck converter output. Connect at least 22 μF output capacitor between this pin and pin 15 (VSS).
VOUT_EN | 6 | Active high digital programming input for enabling/disabling the buck converter. Connect to VSTOR to enable the buck converter.
VOUT_SET | 12 | Connect to the mid-point of external resistor divider between VRDIV and GND for setting the VOUT regulation set point.
VREF_SAMP | 4 | Connect a 0.01-μF low-leakage capacitor from this pin to GND to store the voltage to which VIN_DC will be regulated. This voltage is provided by the MPPT sample circuit.
VRDIV | 8 | Connect high side of resistor divider networks to this biasing voltage.
VSS | 1 | Power ground for the boost charger.
VSS | 15 | Power ground for the buck converter and analog/signal ground for the resistor dividers and VREF_SAMP capacitor.
VSTOR | 19 | Connection for the output of the boost charger. Connect at least a 4.7 μF capacitor in parallel with a 0.1 μF capacitor as close as possible to between this pin and pin 1 (VSS).
PAD | 0

Sheet: EFR32BG13
Pin Name | Designator | Description
Part A - Antenna and Radio Interface
HFXTAL_N | 10 | High Frequency Crystal input pin.
HFXTAL_P | 11 | High Frequency Crystal output pin.
RFVDD | 9 | Radio power supply
PAVDD | 18 | Power Amplifier (PA) voltage regulator VDD input
2G4RF_IOP | 17 | 2.4 GHz Differential RF input/output, positive path.
2G4RF_ION | 16 | 2.4 GHz Differential RF input/output, negative path. This pin should be externally grounded.
RFVSS | 14 | Radio Ground
PAVSS | 15 | Power Amplifier (PA) voltage regulator VSS
Part B - Power and decoupling
RESETn | 12 | Reset input, active low. This pin is internally pulled up to AVDD. To apply an external reset source to this pin, it is required to only drive this pin low during reset, and let the internal pull-up ensure that reset is released.
VREGVDD | 39 | Voltage regulator VDD input
AVDD | 34 | Analog power supply.
IOVDD | 42 | Digital IO power supply.
NC | 13 | No Connect.
VREGSW | 38 | DCDC regulator switching node
DVDD | 40 | Digital power supply.
DECOUPLE | 41 | Decouple output for on-chip voltage regulator. An external decoupling capacitor is required at this pin. This pin should not be used to power any external circuits.
VREGVSS | 37 | Voltage regulator VSS
VSS | 0 | Ground
Part C - I/O Port Pins
PA0 | 25 | GPIO
PA1 | 26 | GPIO
PA2 | 27 | GPIO
PA3 | 28 | GPIO
PA4 | 29 | GPIO
PA5 | 30 | GPIO (5V)
PB11 | 31 | GPIO
PB12 | 32 | GPIO
PB13 | 33 | GPIO
PB14 | 35 | GPIO
PB15 | 36 | GPIO
PC6 | 43 | GPIO (5V)
PC7 | 44 | GPIO (5V)
PC8 | 45 | GPIO (5V)
PC9 | 46 | GPIO (5V)
PC10 | 47 | GPIO (5V)
PC11 | 48 | GPIO (5V)
PD10 | 19 | GPIO (5V)
PD11 | 20 | GPIO (5V)
PD12 | 21 | GPIO (5V)
PD13 | 22 | GPIO
PD14 | 23 | GPIO
PD15 | 24 | GPIO
PF0 | 1 | GPIO (5V)
PF1 | 2 | GPIO (5V)
PF2 | 3 | GPIO (5V)
PF3 | 4 | GPIO (5V)
PF4 | 5 | GPIO (5V)
PF5 | 6 | GPIO (5V)
PF6 | 7 | GPIO (5V)
PF7 | 8 | GPIO (5V)

Sheet: AS5147P
Pin Number | Pin Name | Description
1 | CSn | SPI chip select (active low)
2 | CLK | SPI clock
3 | MISO | SPI master data input, slave output
4 | MOSI | SPI master data output, slave input
5 | Test | Test pin (connect to ground)
6 | B | Incremental signal B
7 | A | Incremental signal A
8 | W/PWM | Commutation signal W or PWM-encoded output
9 | V | Commutation signal V
10 | U | Commutation signal U
11 | VDD | 5V power supply voltage for on-chip regulator
12 | VDD3V3 | 3.3V on-chip low-dropout (LDO) output. Requires an external decoupling capacitor (1μF)
13 | GND | Ground
14 | I | Incremental signal I (index) or PWM

Sheet: radio_board_BOM
P/N: | BRD4104A
Revision: | A00
Description: | EFR32BG13 2.4 GHz 10 dBm Radio Board
Revised: | Wednesday, March 02, 2017
Item | Quantity | Reference | Value | Manufacturer | Manufacturers Part Number | Description | Tolerance | Rating | Technology | Not Mounted | Column1 | Column2 | Column3 | Column4 | Column5
1 | 1 | AT1 | INVERTED_F
2 | 1 | C1 | 1P5 | Murata | GRM1555C1H1R05WA01D |  | ±0.05P | 50V | C0G
3 | 1 | C102 | 100P |  |  |  | 10% | 16V | X7R
4 | 2 | C103,C107 | 10P |  |  | CAP CER NP0 10pF 50V 5% | 5% | 50V | C0G
5 | 1 | C106 | 220N |  |  | CAP CER X7R 220nF 16V 10% | 10% | 16V | X7R
6 | 2 | C110,C112 | 10U |  |  | CAP CER X5R 10uF 6.3V 20% | 20% | 6.3V | X5R
7 | 3 | C111,C114,C117 | 1U |  |  | CAP CER X5R 1uF 25V 10% | 10% | 25V | X5R |  | 1uF | 1 µF ±10% 25V Ceramic Capacitor X5R 0805 (2012 Metric) | GRM216R61E105KA12D Murata Electronics | Capacitors | DigiKey (https://www.digikey.com/en/products/detail/murata-electronics/GRM216R61E105KA12D/586873) | https://www.murata.com/-/media/webrenewal/support/library/catalog/products/capacitor/ceramiccapacitor/c02e.ashx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 | Rajat
8 | 1 | C113 | 10N |  |  | CAP CER X7R 10nF 16V 10% | 10% | 16V | X7R
9 | 1 | C115 | 4U7 |  |  |  | 10% | 25V | X5R |  | 4.7uF | CL10 Series 4.7 uF 10 V ±10 % Tolerance X5R SMT Multilayer Ceramic Capacitor | CL10A475KP8NNNC Samsung Electro-Mechanics | Capacitors | DigiKey (https://www.digikey.com/en/products/detail/samsung-electro-mechanics/CL10A475KP8NNNC/3886702) | CL10A475KP8NNNC_Spec.pdf (digikey.com) (https://media.digikey.com/pdf/Data%20Sheets/Samsung%20PDFs/CL10A475KP8NNNC_Spec.pdf) | Rajat
10 | 6 | C116,C124,C200,C201,C203,C207 | 100N |  |  | CAP CER X7R 100nF 16V 10% | 10% | 16V | X7R |  | 0.1uF | CAP CER 0.1UF 16V X7R 0805 | C0805C104K4RACAUTO KEMET | Capacitors | DigiKey (https://www.digikey.com/en/products/detail/kemet/C0805C104K4RACAUTO/10642389) | https://api.kemet.com/component-edge/download/datasheet/C0805C104K4RACAUTO.pdf | Rajat
11 | 1 | C205 | 10U |  |  |  |  |  | X5R | NM
12 | 2 | L1,L2 | 1N9 | Murata | LQP15MN1N9W02D |  | ±0.05N
13 | 1 | L100 | CBF102WB | Würth Electronics | 74279266 | FERRITE BEAD 1000R 200mA
14 | 1 | L101 | 4U7 | Murata | LQH3NPN4R7MM0L | INDUCTOR POWER 4.7uH 1.25A 20% |  |  |  |  | 4.7uH | FIXED IND 4.7UH 1.2A 186MOHM SMD | LQH32PH4R7NNCL Murata Electronics | Inductors, Coils, Chokes | DigiKey (https://www.digikey.com/en/products/detail/murata-electronics/LQH32PH4R7NNCL/6799435) | JELF243A-9135.pdf (murata.co.jp) (https://search.murata.co.jp/Ceramy/image/img/P02/JELF243A-9135.pdf) | Rajat
15 | 2 | L102,L103 | BLM18AG601SN1 | Murata | BLM18AG601SN1
16 | 1 | PCB1 | PCB4104A |  | PCB4104A Rev. A02
17 | 1 | P1 | U.FL | Hirose | U.FL-R-SMT-1
18 | 2 | P200,P201 | SOCKET_2X20_1.27MM_SMD | Samtec | SFC-120-T2-L-D-A-K-TR | CONN SOCKET STRIP 1.27mm
19 | 1 | RP200 | 100R | ROHM | MNR04M0APJ101 | RES ARRAY 100R 5% CONVEX
20 | 5 | R1,R201,R205,R208,R211 | 0R |  |  | RES 0R Imax 2A JUMPER
21 | 4 | R2,R206,R207,R210 | 0R |  |  |  |  |  |  | NM
22 | 1 | R100 | 1R |  |  | RES 1R 1/16W 1% 200ppm
23 | 1 | R103 | 330K |  |  | RES 330K 1/16W 1% 100ppm
24 | 1 | R200 | 10K |  |  | RES 10K 1/16W 1% 100ppm
25 | 1 | SH100 | RF_SHIELD_FRAME_BMI-S-203-F | Laird Technologies | BMI-S-203-F |  |  |  |  | NM
26 | 1 | SH101 | RF_SHIELD_COVER_BMI-S-203-C | Laird Technologies | BMI-S-203-C |  |  |  |  | NM
27 | 20 | TPJ1,TPJ2,TPJ3,TPJ4,TPJ5,TPJ6,TPJ7,TPJ8,TPJ9,TPJ10,TPJ11,TPJ12,TPJ13,TPJ14,TPJ15,TPJ16,TPJ17,TPJ18,TPJ19,TPJ20 | TPJ_SMD
28 | 1 | U1 | EFR32BG13P632F512GM48 | Silicon Labs | EFR32BG13P632F512GM48-BR
29 | 1 | U100 | MX25R8035F | Macronix | MX25R8035FBDIL0 | IC SERIAL FLASH 8Mb
30 | 1 | U200 | 24AA024 | Microchip | 24AA024T-I/MNY | IC EEPROM 2KBIT SERIAL
31 | 1 | X1 | 38.4MHz | KDS | DSX211SH 38.4 MHz 1ZZNAE38400AB0A
32 | 1 | X2 | 32.768 kHz | KDS | DST210A 1TJG125DP1A0012
