rajatchaple/cubit_3.0/pcb/Cubit3_main_pcb.step

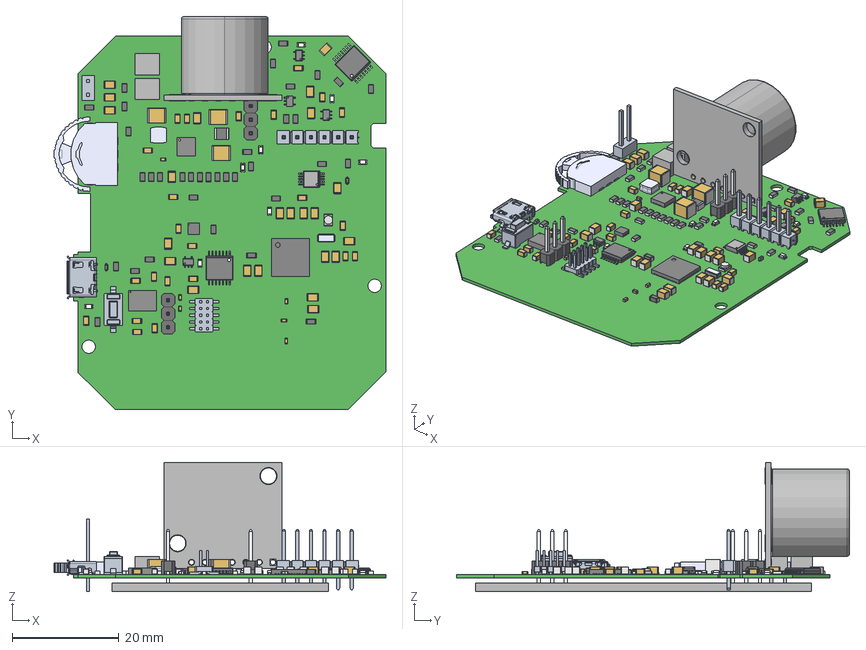
[picture p15: CAD file, 2025-04-21]
pcb/Cubit3_main_pcb.step
62.1 x 73.6 x 24.2 mm
Mid_Body x 33
Mark x 33
TPS22942DCKR x 4
Ultrasonic sensor_RGB8421504
Leader x 38
NAV_SWITCH
ECS-.327-7-34B-TR
102972-2--3DModel-STEP-1
1 row end bumps format x 6
BNO055--3DModel-STEP-56544
pins x 2
logo x 2
Thermal_Shape
PTS636SL43SMTRLFS_PART1
PTS636SL43SMTRLFS_PART2
PTS636SL43SMTRLFS_PART3
PTS636SL43SMTRLFS_PART4
PTS636SL43SMTRLFS_PART5
PTS636SL43SMTRLFS_PART6
PTS636SL43SMTRLFS_PART7
PTS636SL43SMTRLFS_PART8
PTS636SL43SMTRLFS_PART9
PTS636SL43SMTRLFS_PART10
housing x 8
cover x 8
base x 16
Polarity Mark x 8
Extruded x 3
vls3015cx-1
_TSW-106-23-T-S_body
_T-1S6-16-TSW-1-23-6-S
10118194c
20021121-00010C1LF--3DModel-STEP-533217
