rajatchaple/cubit_3.0/Assembly/Parts/Cubit3_main_pcb.step

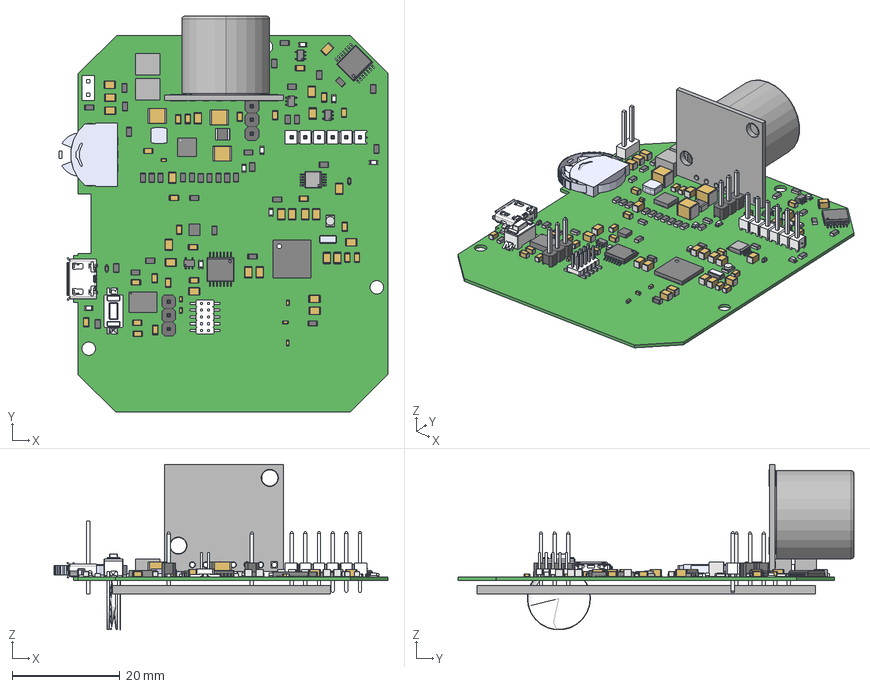
[picture p16: CAD file, 2025-04-21]
Assembly/Parts/Cubit3_main_pcb.step
62.1 x 73.6 x 30.8 mm
