rajatchaple/cubit_3.0/Assembly/Parts_cnc/Cubit3_main_pcb.SLDPRT

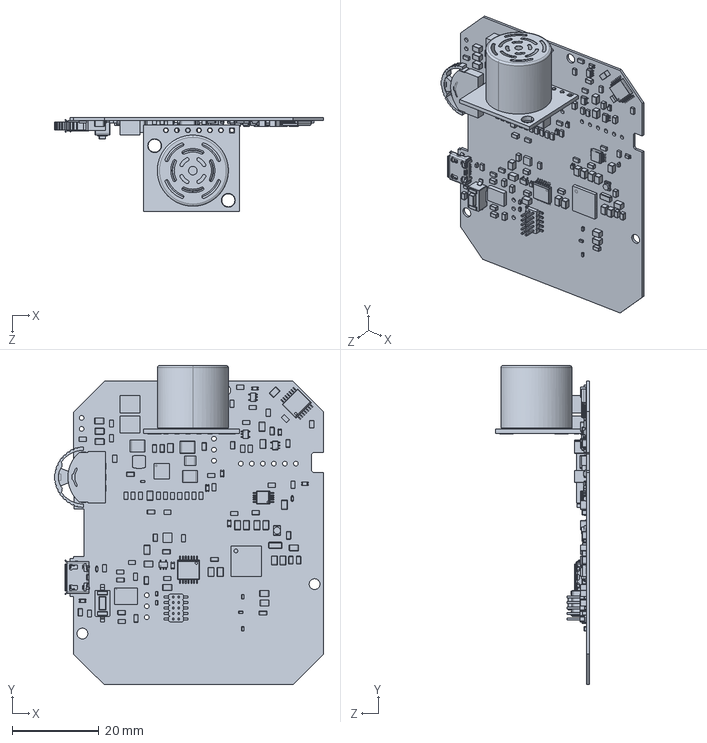
[picture p17: CAD file, 2025-04-21]
Assembly/Parts_cnc/Cubit3_main_pcb.SLDPRT
62.1 x 73.6 x 21.6 mm
