rajatchaple/cubit_3.0/Assembly/Parts/cubit3_wheel.STEP

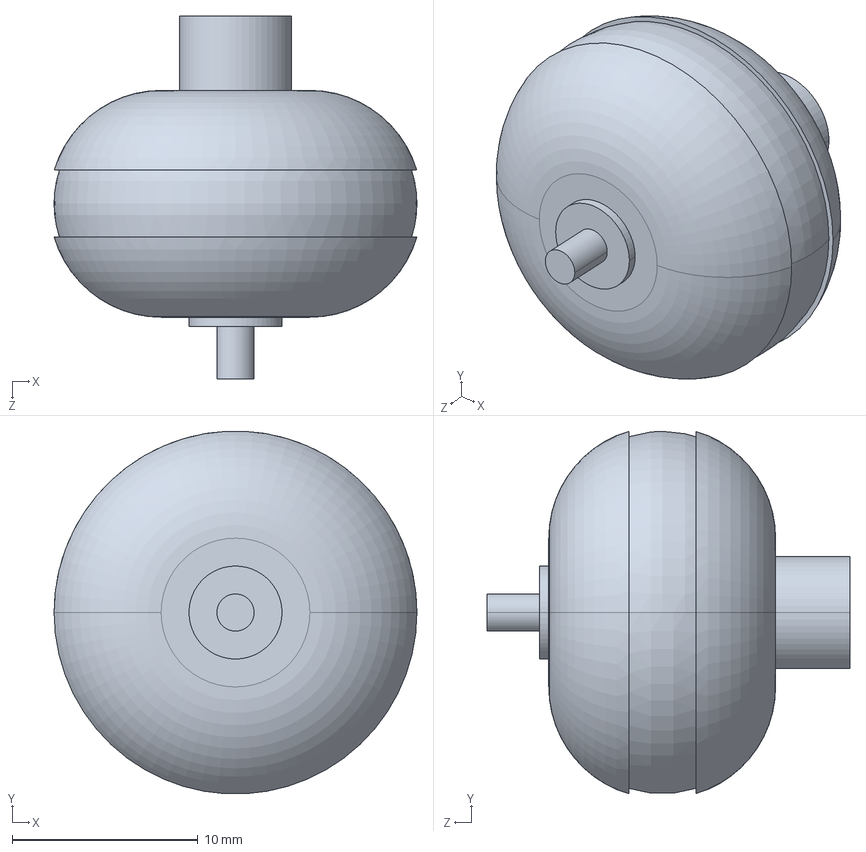
[picture p18: CAD file, 2025-08-10]
Assembly/Parts/cubit3_wheel.STEP
19.5 x 19.5 x 19.5 mm
