rajatchaple/cubit_3.0/Assembly/Parts_cnc/cubit3_mag_support_P.STEP

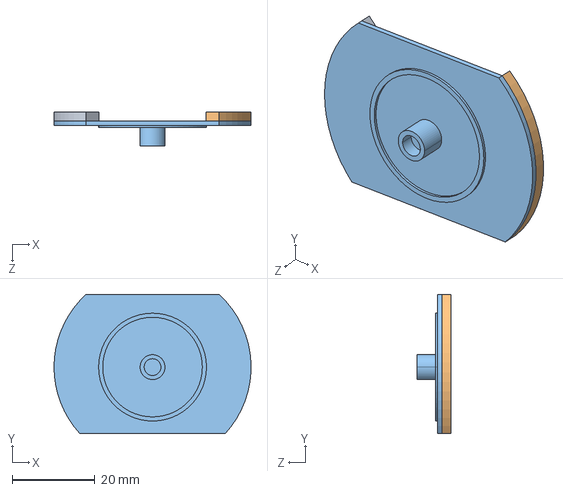
[picture p19: CAD file, 2025-08-10]
Assembly/Parts_cnc/cubit3_mag_support_P.STEP
47.5 x 33.6 x 8.20 mm
