rajatchaple/cubit_3.0/Assembly/Parts_cnc/output/corrections_by_jlcpcb/cubit2_bottom_enclosure.STEP

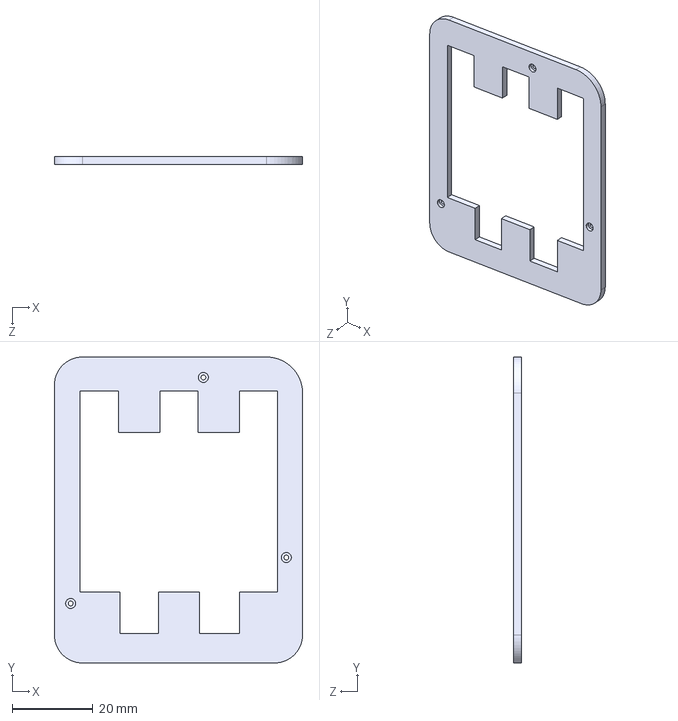
[picture p20: CAD file, 2025-04-21]
Assembly/Parts_cnc/output/corrections_by_jlcpcb/cubit2_bottom_enclosure.STEP
61.7 x 76.0 x 2.00 mm
