rajatchaple/cubit_3.0/Assembly/Parts_cnc/output/cubit2_top_enclosure.STEP

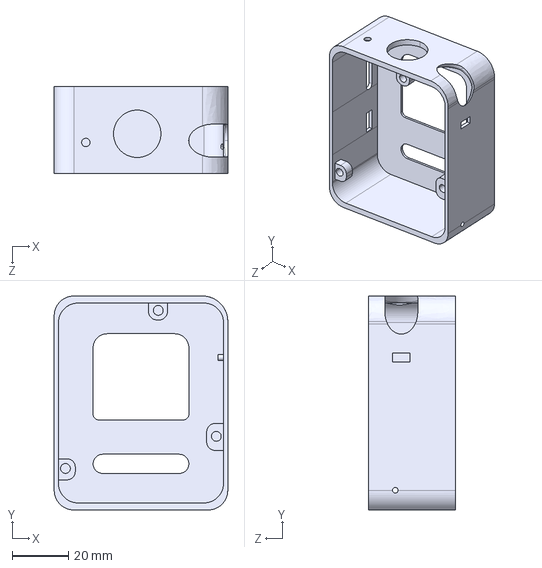
[picture p21: CAD file, 2025-04-21]
Assembly/Parts_cnc/output/cubit2_top_enclosure.STEP
61.7 x 76.0 x 30.9 mm
