rajatchaple/cubit_3.0/pcb/Cubit3_solar_panel.step

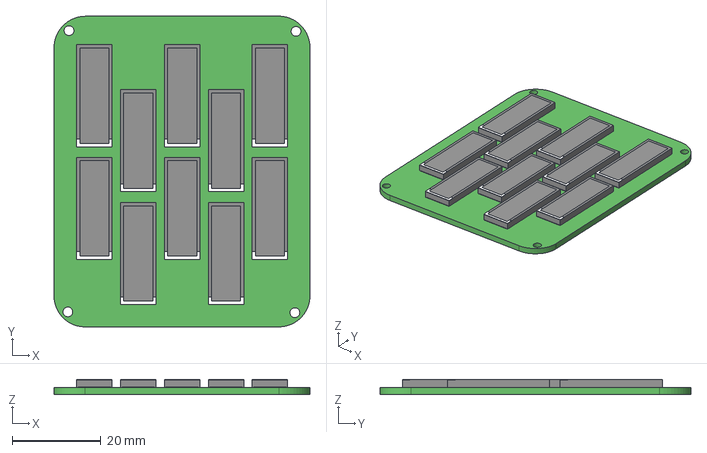
[picture p22: CAD file, 2025-04-21]
pcb/Cubit3_solar_panel.step
57.7 x 70.0 x 3.42 mm
