rajatchaple/cubit_3.0/pcb_library/component_3D_steps/PTS636SL43SMTRLFS.stp

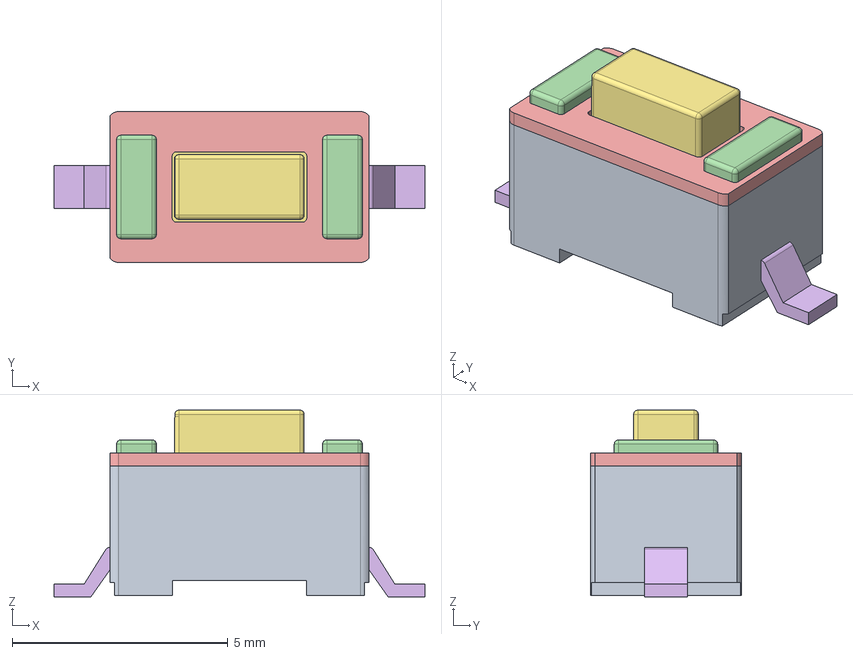
[picture p23: CAD file, 2025-04-21]
pcb_library/component_3D_steps/PTS636SL43SMTRLFS.stp
8.60 x 3.50 x 4.33 mm
PTS636SL43SMTRLFS_PART1
PTS636SL43SMTRLFS_PART2
PTS636SL43SMTRLFS_PART3
PTS636SL43SMTRLFS_PART4
PTS636SL43SMTRLFS_PART5
PTS636SL43SMTRLFS_PART6
PTS636SL43SMTRLFS_PART7
PTS636SL43SMTRLFS_PART8
PTS636SL43SMTRLFS_PART9
PTS636SL43SMTRLFS_PART10
