rajatchaple/cubit_3.0/Assembly/Parts_cnc/output/corrections_by_jlcpcb/support1.STEP

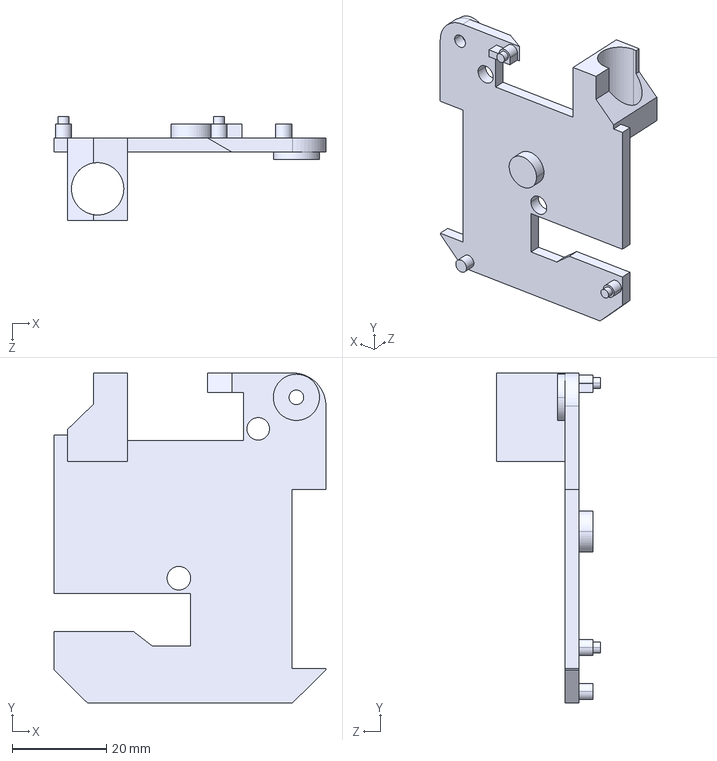
[picture p25: CAD file, 2025-04-21]
Assembly/Parts_cnc/output/corrections_by_jlcpcb/support1.STEP
57.7 x 70.0 x 22.1 mm
