rajatchaple/cubit_3.0/pcb_library/component_3D_steps/KXOB25-14X1F-TR--3DModel-STEP-269445.STEP

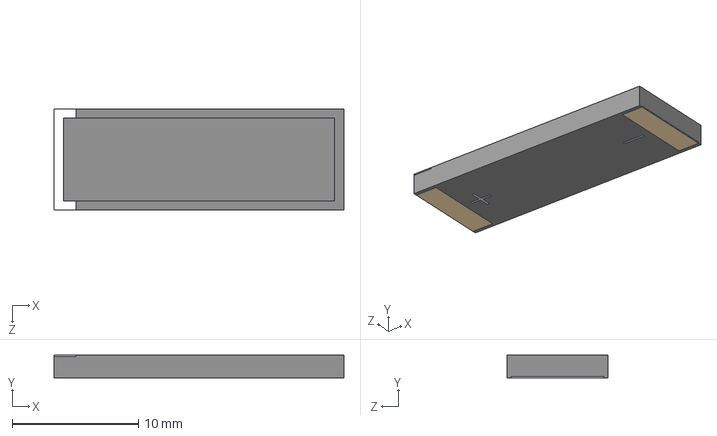
[picture p26: CAD file, 2025-04-21]
pcb_library/component_3D_steps/KXOB25-14X1F-TR--3DModel-STEP-269445.STEP
23.0 x 1.80 x 8.00 mm
