rajatchaple/cubit_3.0/Assembly/Parts/cubit3_support2.STEP

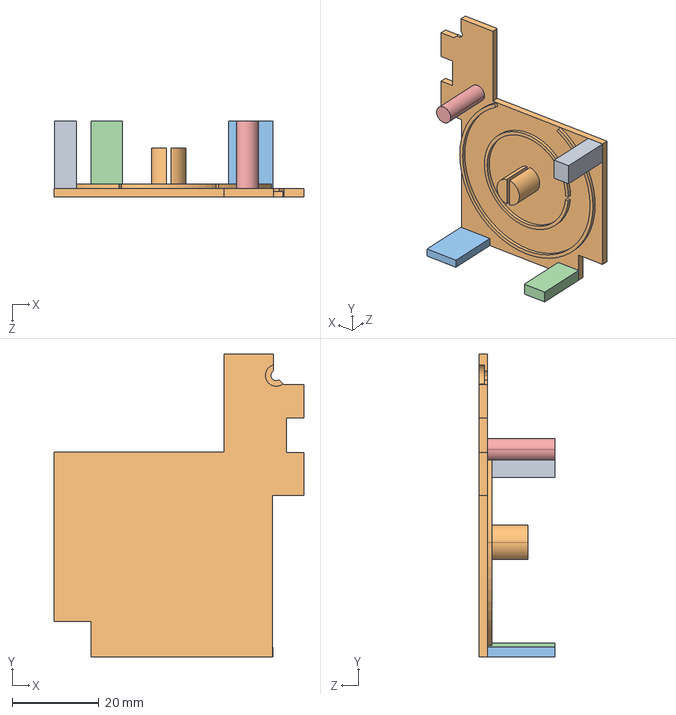
[picture p27: CAD file, 2025-08-10]
Assembly/Parts/cubit3_support2.STEP
57.7 x 70.0 x 17.5 mm
