rajatchaple/cubit_3.0/Assembly/Parts_cnc/cubit3_bottom_enclosure.STEP

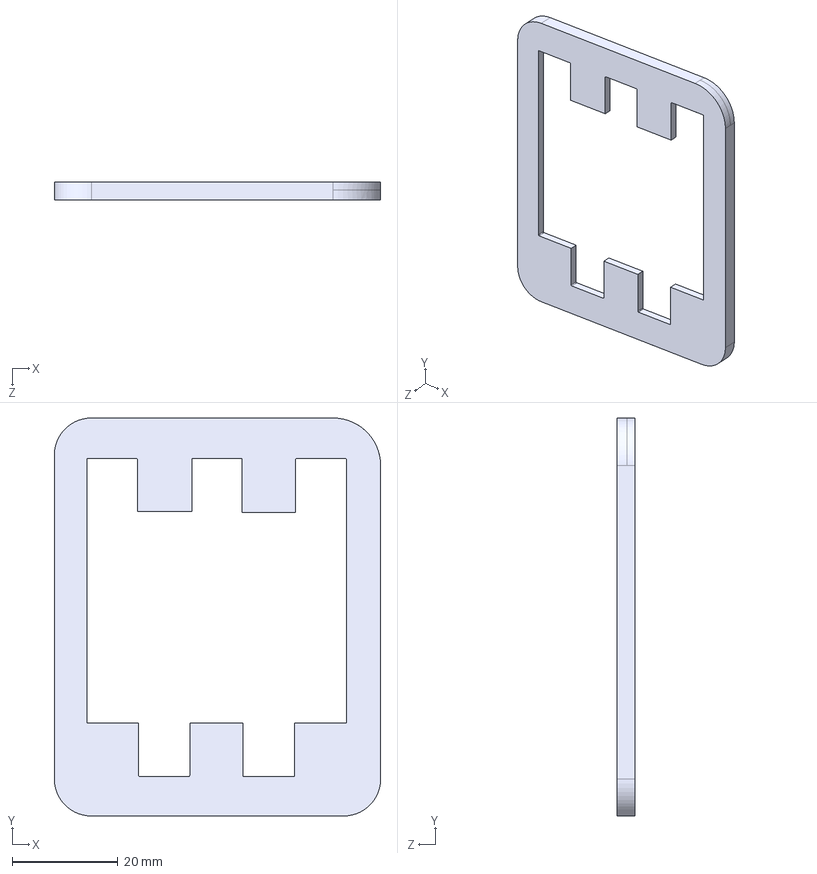
[picture p28: CAD file, 2025-08-10]
Assembly/Parts_cnc/cubit3_bottom_enclosure.STEP
61.7 x 75.3 x 3.40 mm
