rajatchaple/cubit_3.0/Assembly/Parts_cnc/output/corrections_by_jlcpcb/support2.STEP

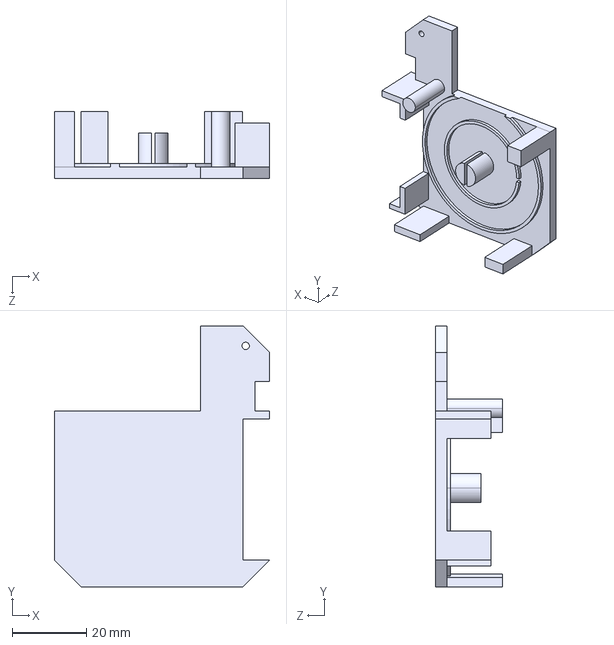
[picture p29: CAD file, 2025-04-21]
Assembly/Parts_cnc/output/corrections_by_jlcpcb/support2.STEP
58.1 x 70.5 x 18.0 mm
