rajatchaple/cubit_3.0/Assembly/Parts/cubit3_top_enclosure.STEP

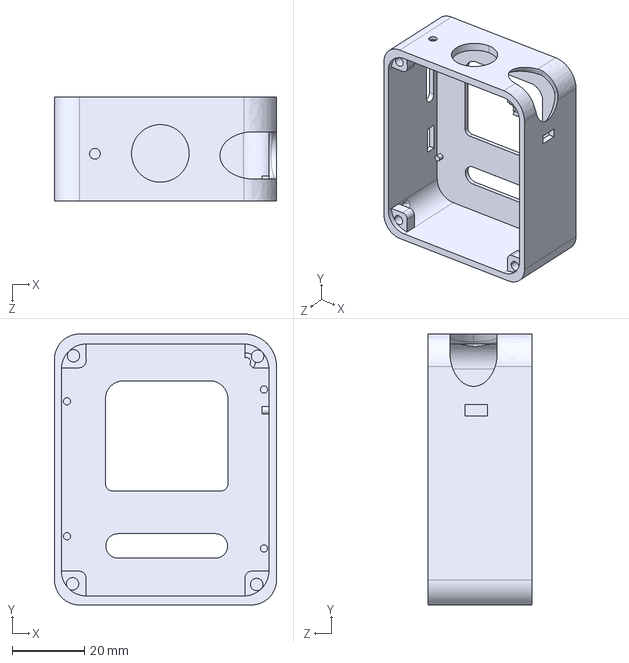
[picture p30: CAD file, 2025-08-10]
Assembly/Parts/cubit3_top_enclosure.STEP
61.7 x 75.3 x 29.0 mm
