rajatchaple/cubit_3.0/Assembly/Parts_cnc/cubit3_support1.STEP

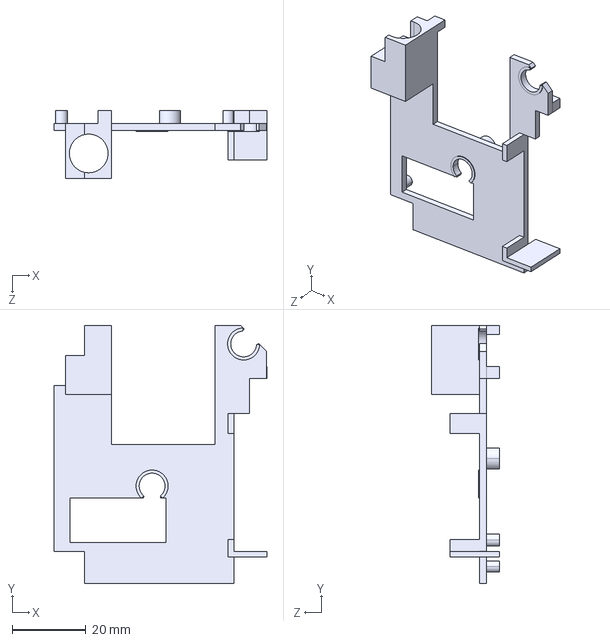
[picture p31: CAD file, 2025-08-10]
Assembly/Parts_cnc/cubit3_support1.STEP
57.7 x 70.0 x 18.5 mm
