rajatchaple/cubit_3.0/Assembly/Parts_cnc/cubit3_support2.STEP

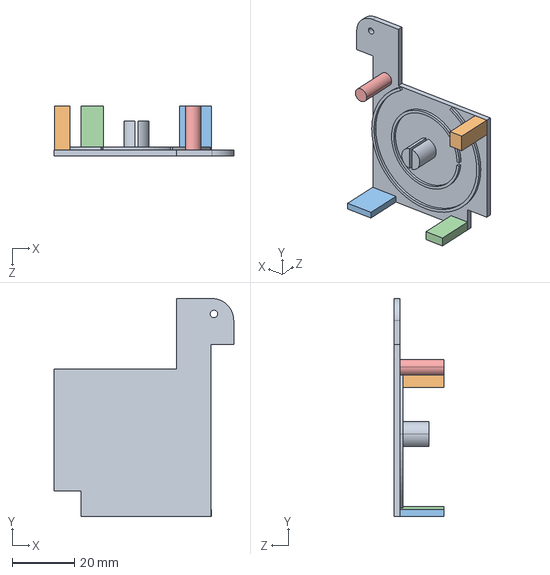
[picture p32: CAD file, 2025-08-10]
Assembly/Parts_cnc/cubit3_support2.STEP
57.7 x 70.0 x 16.2 mm
