rajatchaple/cubit_3.0/Assembly/Parts_cnc/output/mag_support_P.STEP

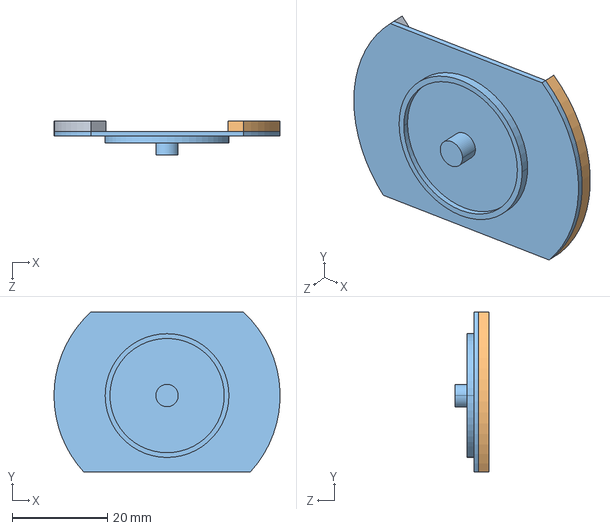
[picture p33: CAD file, 2025-04-21]
Assembly/Parts_cnc/output/mag_support_P.STEP
47.5 x 33.6 x 7.20 mm
