rajatchaple/cubit_3.0/Assembly/Parts/cubit3_mag_support_P.STEP

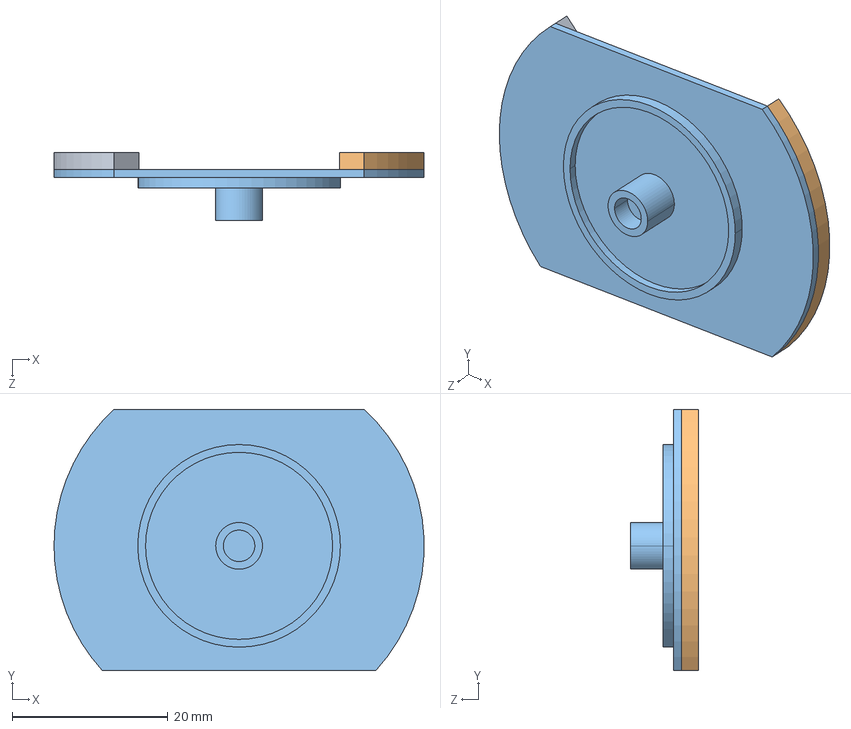
[picture p34: CAD file, 2025-08-10]
Assembly/Parts/cubit3_mag_support_P.STEP
47.5 x 33.6 x 8.70 mm
