rajatchaple/cubit_3.0/Assembly/Parts_cnc/output/wheel.STEP

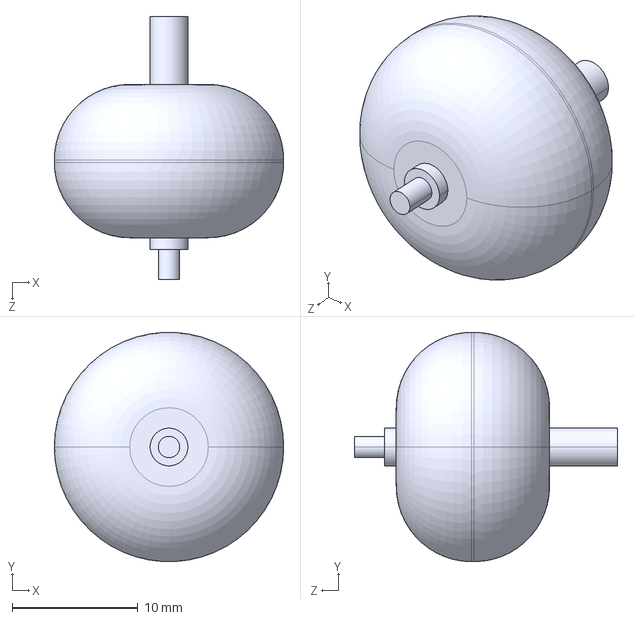
[picture p35: CAD file, 2025-04-21]
Assembly/Parts_cnc/output/wheel.STEP
18.2 x 18.2 x 20.9 mm
