rajatchaple/cubit_3.0/Assembly/Parts_cnc/cubit3_top_enclosure.STEP

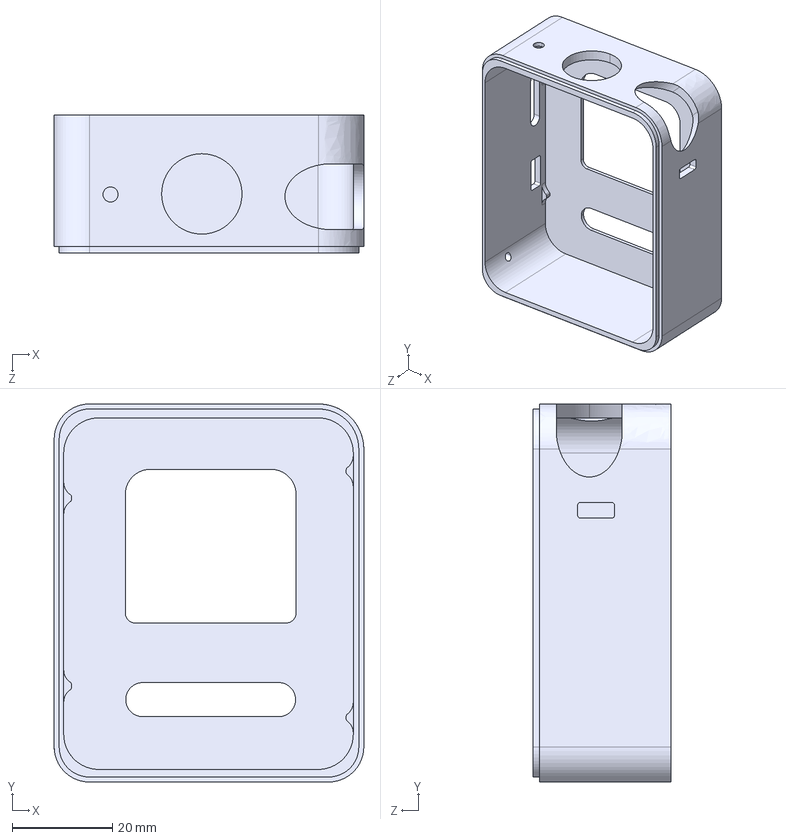
[picture p36: CAD file, 2025-08-10]
Assembly/Parts_cnc/cubit3_top_enclosure.STEP
61.7 x 75.3 x 27.5 mm
