rajatchaple/cubit_3.0/Assembly/Parts_cnc/switch.SLDPRT

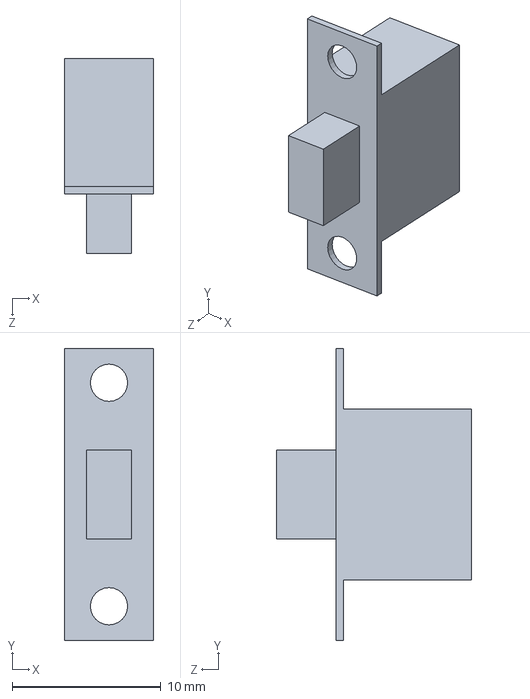
[picture p37: CAD file, 2025-04-21]
Assembly/Parts_cnc/switch.SLDPRT
6.00 x 19.6 x 13.1 mm
