rajatchaple/cubit_3.0/Assembly/Parts_cnc/Pulley_real_size.SLDPRT

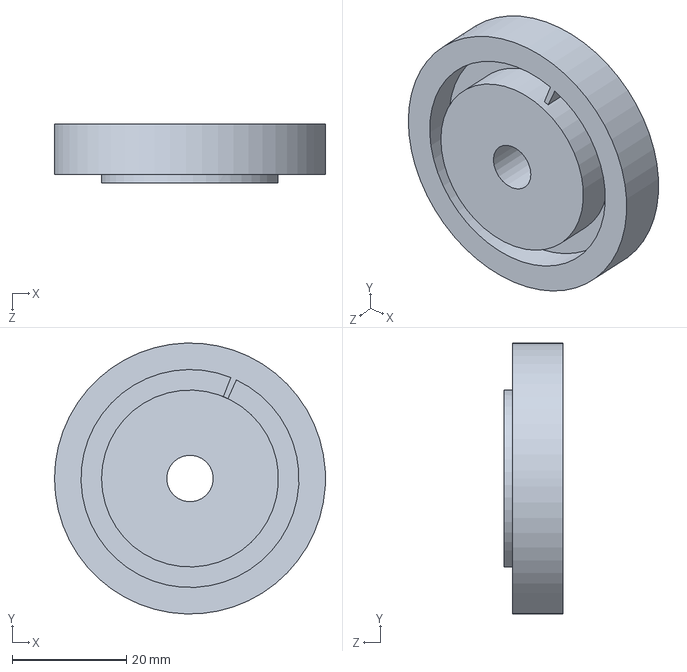
[picture p38: CAD file, 2025-04-21]
Assembly/Parts_cnc/Pulley_real_size.SLDPRT
47.5 x 47.5 x 10.4 mm
