rajatchaple/cubit_3.0/Assembly/Parts_cnc/battery.SLDPRT

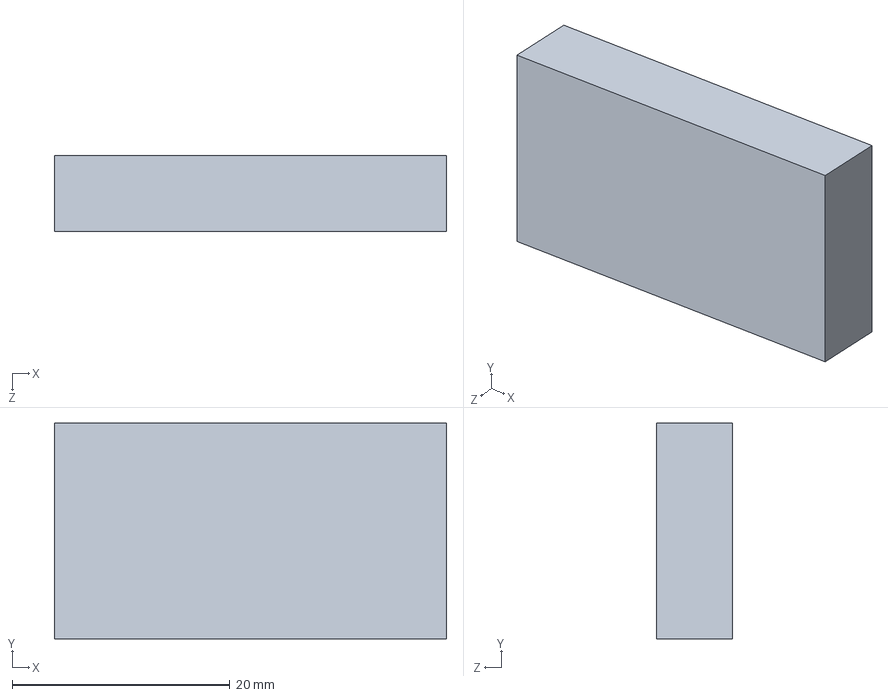
[picture p39: CAD file, 2025-04-21]
Assembly/Parts_cnc/battery.SLDPRT
36.0 x 19.8 x 7.00 mm
