rajatchaple/cubit_3.0/Assembly/cubit2_assembly.SLDASM

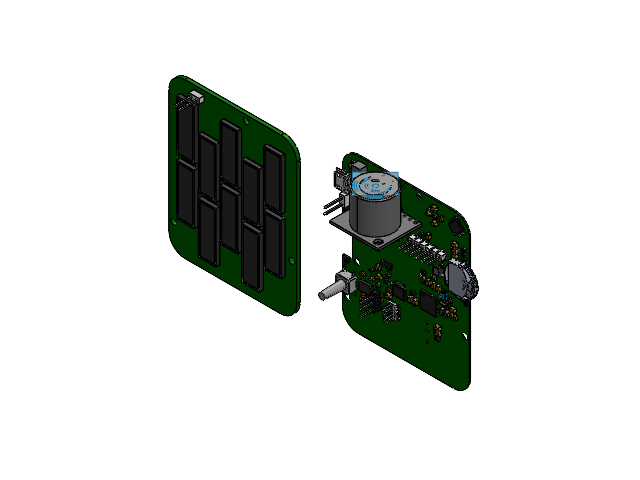
[picture p40: CAD file, 2025-04-21]
Assembly/cubit2_assembly.SLDASM
Cubit2_solar_panel.step
Cubit2_main_pcb.step
