rajatchaple/cubit_3.0/(list of files, cad)

Other CAD files:
Assembly/Parts_cnc/Cubit3_solar_panel.SLDPRT
Assembly/Parts_cnc/output/cubit2_bottom_enclosure.STEP
Assembly/Parts_cnc/output/support2.STEP
Assembly/Parts_cnc/output/support1.STEP
Assembly/Parts/Cubit3_solar_panel.step
Assembly/Parts_cnc/cubit3_wheel.STEP
Assembly/Parts/cubit3_bottom_enclosure.STEP
Assembly/Parts/cubit3_mag_support_P.SLDPRT
Assembly/Parts/cubit3_support1.SLDPRT
Assembly/Parts/cubit3_support2.SLDPRT
Assembly/Parts_cnc/cubit3_mag_support_P.SLDPRT
Assembly/Parts_cnc/cubit3_support2.SLDPRT
Assembly/Parts_cnc/cubit3_wheel.SLDPRT
Assembly/Parts_cnc/old/Pulley.SLDPRT
Assembly/Parts_cnc/old/Pulley_old.SLDPRT
Assembly/Parts_cnc/old/cubit2_bottom_assembly.SLDPRT
Assembly/Parts_cnc/old/cubit2_top_assembly.SLDPRT
Assembly/Parts_cnc/old/top_assembly.SLDPRT
