rajatchaple/cubit_3.0/misc/lcd_screens_builder/LCD_screens_cubit2.pptx

## linear_string

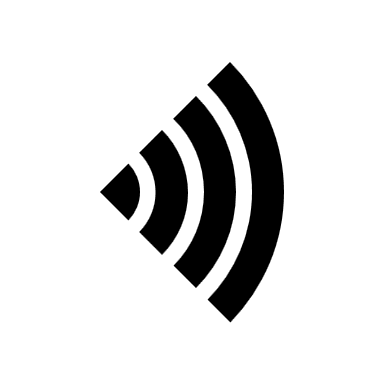
[picture p41: figure]
Wi-Fi with solid fill
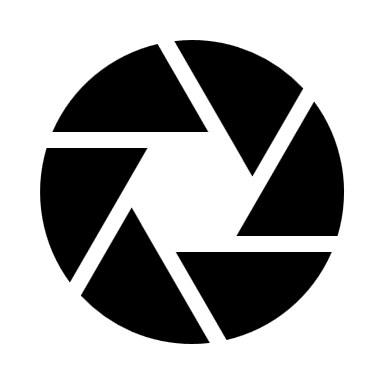
[picture p42: figure]
Aperture with solid fill
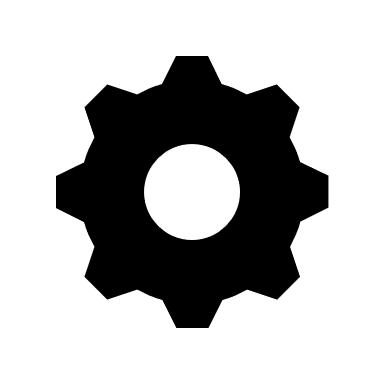
[picture p43: figure]
Single gear with solid fill
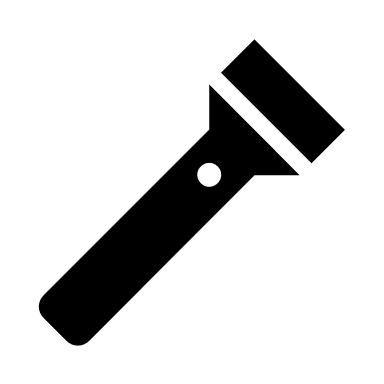
[picture p44: figure]
Flashlight with solid fill
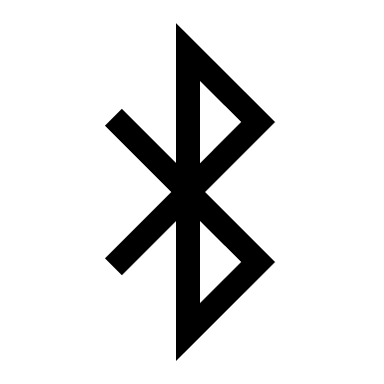
[picture p45: figure]
Bluetooth with solid fill

## linear_string

1

2

Graphics

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
## linear_string
