rajatchaple/cubit_3.0/misc/lcd_screens_builder/LCD_screens_cubit2_Icons.pptx

## linear_string

Wi-Fi with solid fill
Aperture with solid fill
Single gear with solid fill
Flashlight with solid fill
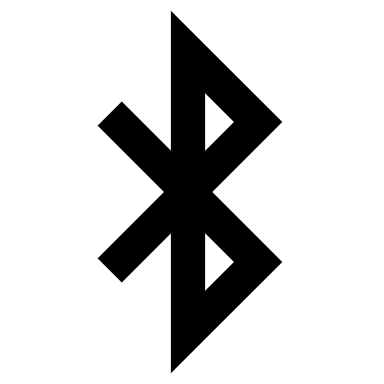
[picture p46: figure]
Bluetooth with solid fill
