rajatchaple/cubit_3.0/misc/lcd_screens_builder/old/LCD_screeens - Copy.pptx

## menu_linear

LINEARRR
ANGULAR
SETTINGS

MENU

N
cm / inch

## menu_angular

LINEAR
ANGULAR
SETTINGS

MENU

N
degrees

## menu_settings

LINEAR
ANGULAR
SETTINGS

MENU

Single gear with solid fill

## linear_string

LINEAR

STRING
WHEEL
SONIC

N
cm / inch

## linear_wheel

LINEAR

STRING
WHEEL
SONIC

N
cm / inch

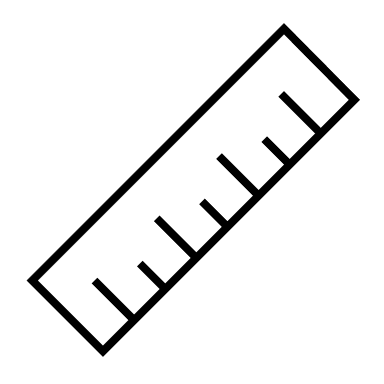
[picture p47: figure]
Ruler outline

## linear_sonic

LINEAR

STRING
WHEEL
SONICc

N
cm / inch

## string_meas_cm

Click Enter to save

STRING

cm

## string_meas_inch

Click Enter to save

STRING

inch

## wheel_meas_inch

Click Enter to save

WHEEL

inch

## wheel_meas_cm

Click Enter to save

WHEEL

cm

## sonic_meas_inch

Click Enter to save

SONIC

inch

## sonic_meas_cm

Click Enter to save

SONIC

cm

## angular_meas

ANGULAR

Click Enter to save

deg

## settings_unit

SETTINGS

Unittttttttttttt
Charge Status

## unit_cm

cmtttttttttttttt
inch

Unit

## unit_inch

cmttttttttttttt
inchge Statuss

Unit

## settings_charge_status

SETTINGS

Unittttttttttttt
Charge Status

## charge_status_on

Charge Status

Keep LCD on while charging?

ON (may affect battery life))
OFF

## charge_status_off

Charge Status

Keep LCD on while charging?

ON (may affect battery life)
OFFffffffffffffs

## Slide 20

## Slide 21

## Slide 22
