rajatchaple/cubit_3.0/misc/lcd_screens_builder/old/LCD_screeens_NewAlgo.pptx

## menu_linear

LINEAR

ANGULAR

SETTINGS

MENU

N
cm / inch

## linear_string

LINEAR

STRING

WHEEL

SONIC

N
cm / inch

## string_meas_cm

Click Enter to save

STRING

## wheel_meas_inch

Click Enter to save

WHEEL

## sonic_meas_cm

Click Enter to save

SONIC

## angular_meas

ANGULAR

Click Enter to save

deg

## settings_unit

SETTINGS

Unit

Status

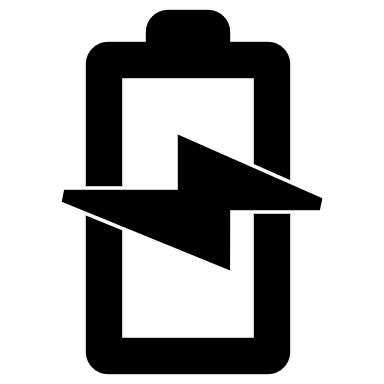
[picture p48: figure]
Battery charging with solid fill

## unit_cm

Unit

cm

inch

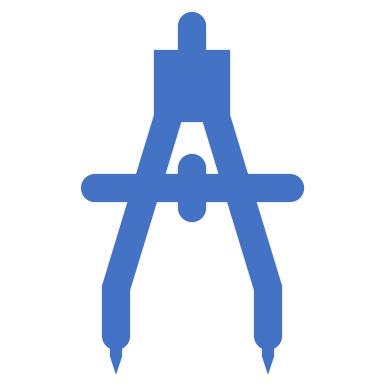
[picture p49: figure]
Drawing Compass

## charge_status_on

Charge Status

Keep LCD on while charging?

ON

OFF
