rajatchaple/cubit_3.0/misc/lcd_screens_builder/cubit3/screen_images/LCD_screens_cubit2.png

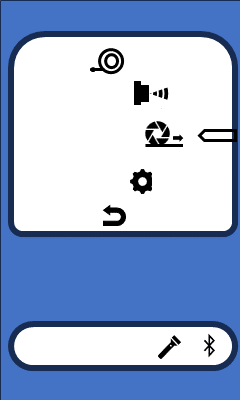
misc/lcd_screens_builder/cubit3/screen_images/LCD_screens_cubit2.png
