rajatchaple/cubit_3.0/misc/lcd_screens_builder/cubit3/screen_images/menu_frame.png

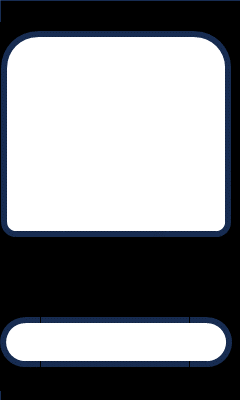
misc/lcd_screens_builder/cubit3/screen_images/menu_frame.png
