rajatchaple/cubit_3.0/misc/lcd_screens_builder/screens/LCD_screeens/angular_meas.PNG

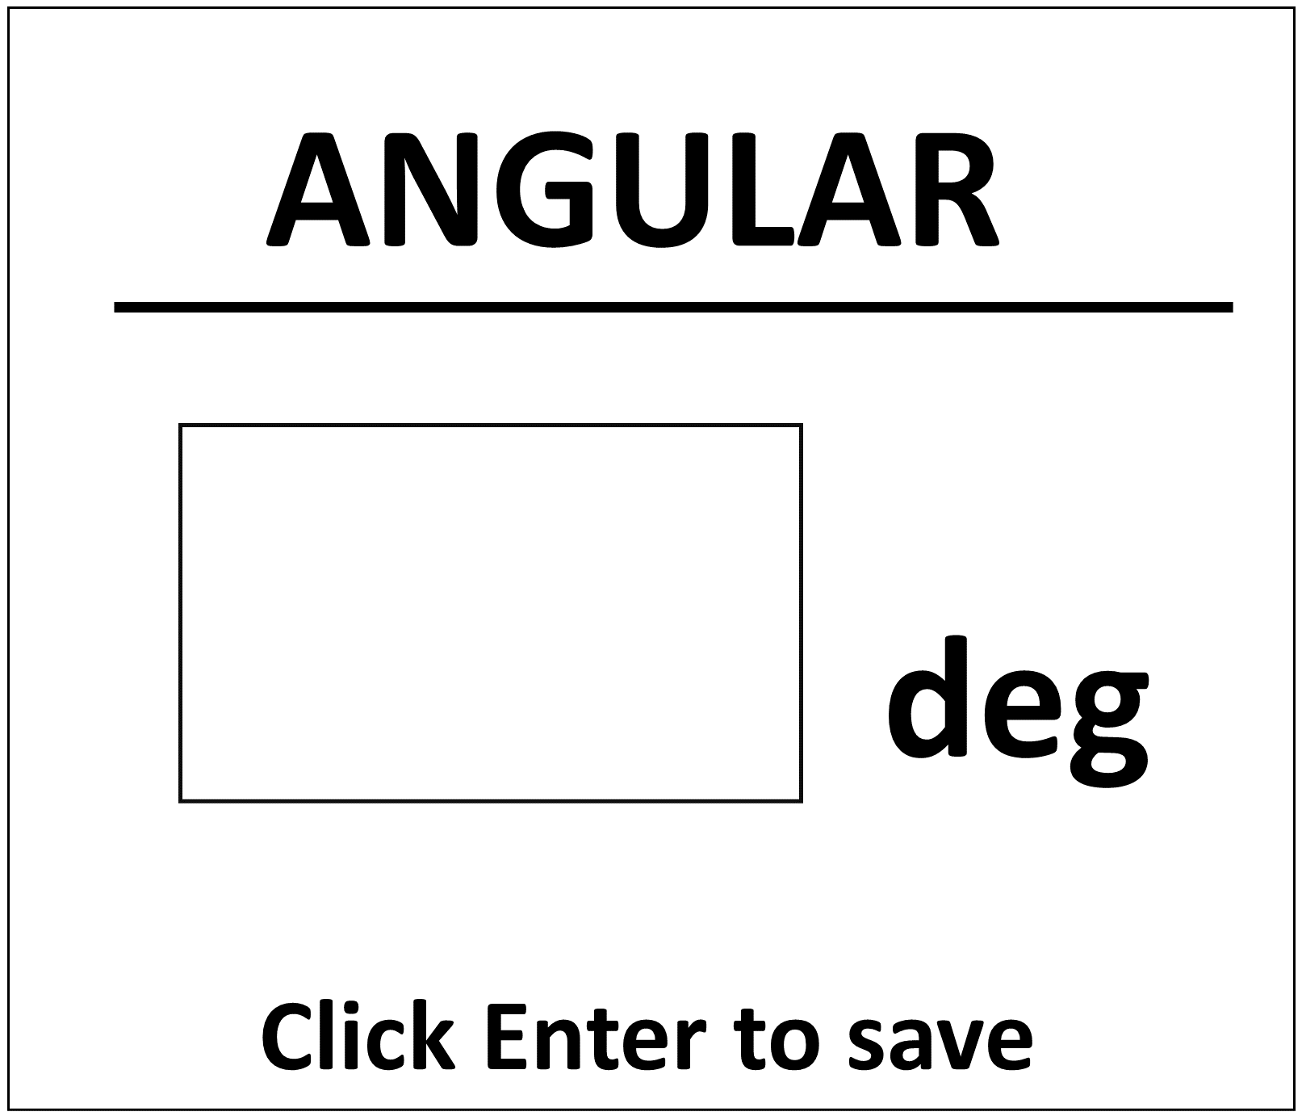
misc/lcd_screens_builder/screens/LCD_screeens/angular_meas.PNG
