rajatchaple/cubit_3.0/misc/lcd_screens_builder/screens/LCD_screeens/charge_status_off.PNG

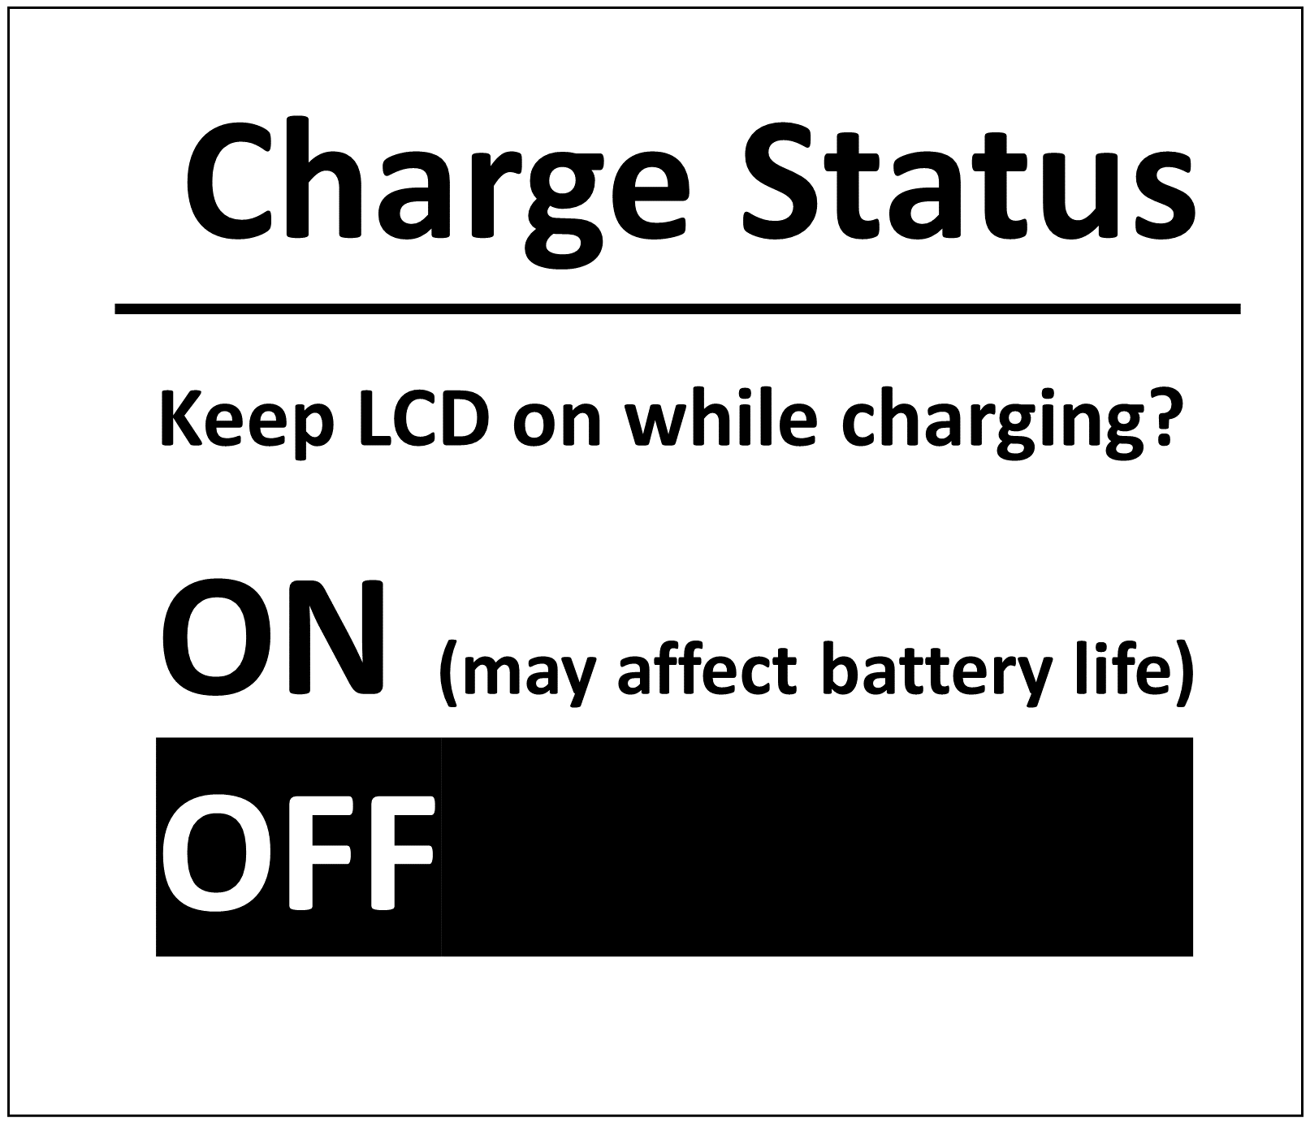
misc/lcd_screens_builder/screens/LCD_screeens/charge_status_off.PNG
