rajatchaple/cubit_3.0/misc/lcd_screens_builder/screens/LCD_screeens/charge_status_on.PNG

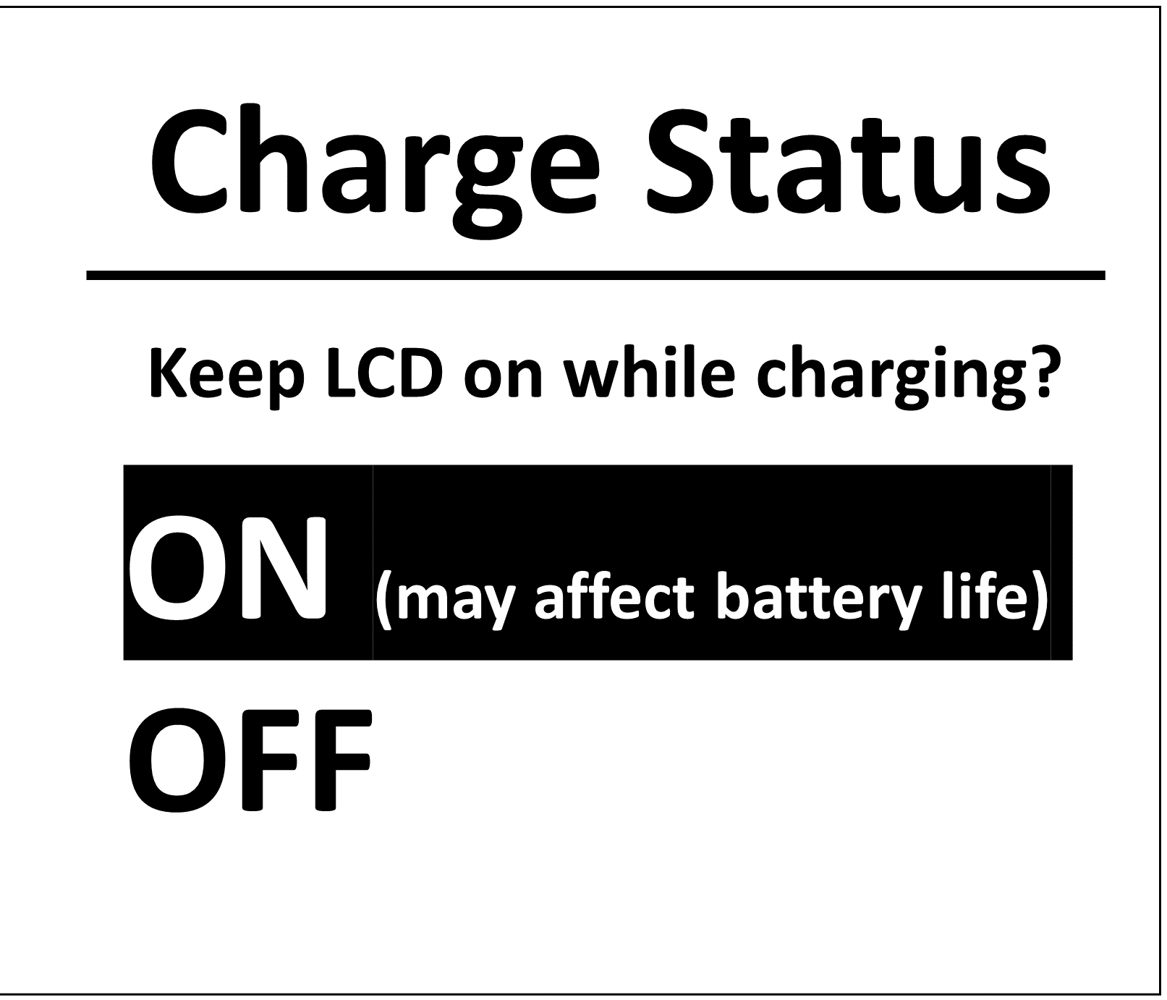
misc/lcd_screens_builder/screens/LCD_screeens/charge_status_on.PNG
