rajatchaple/cubit_3.0/misc/lcd_screens_builder/screens/LCD_screeens/CU.png

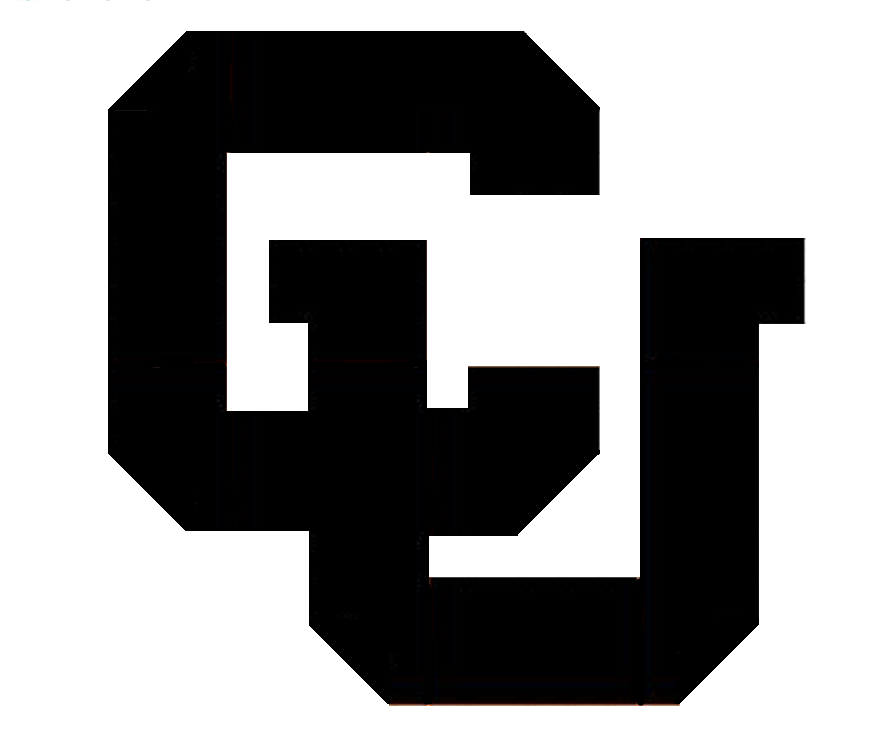
misc/lcd_screens_builder/screens/LCD_screeens/CU.png
