rajatchaple/cubit_3.0/misc/lcd_screens_builder/screens/LCD_screeens/linear_string.PNG

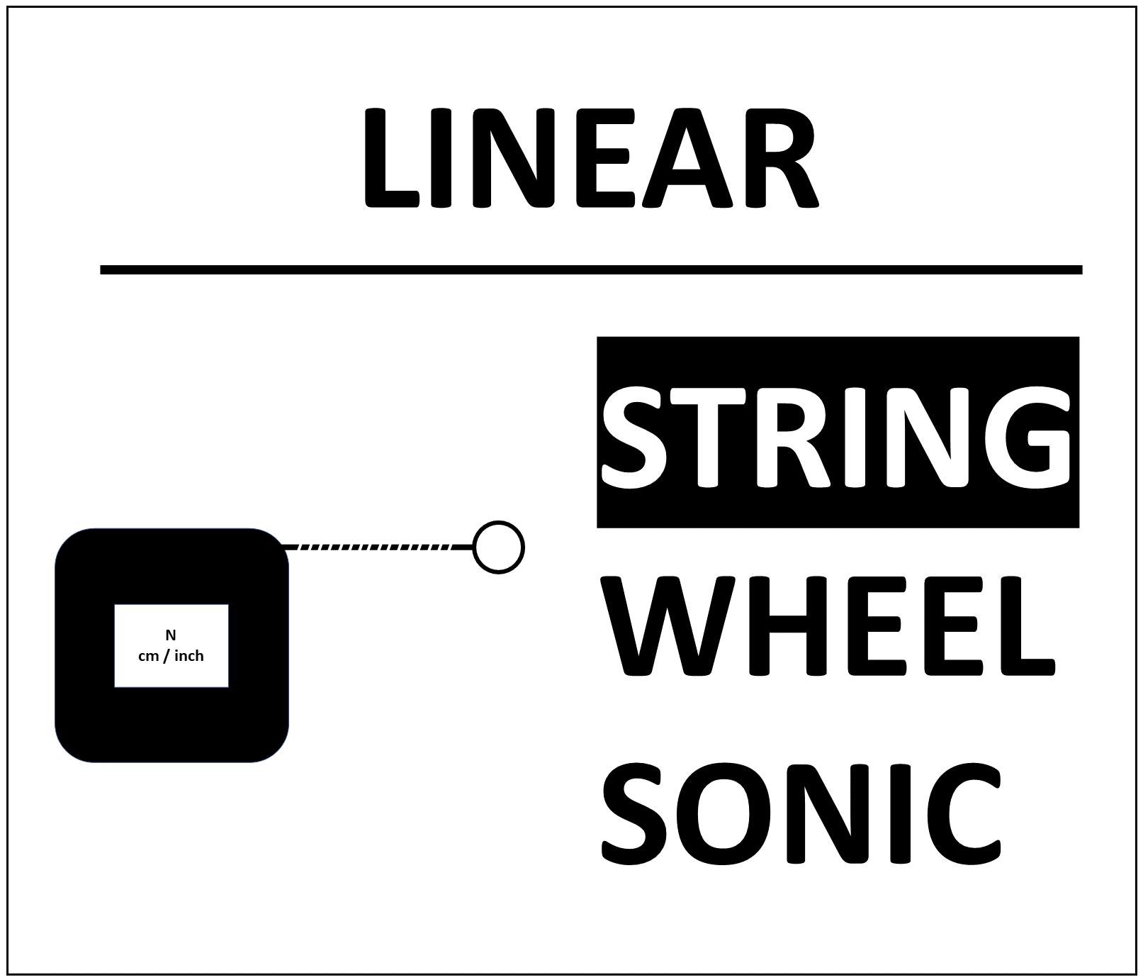
misc/lcd_screens_builder/screens/LCD_screeens/linear_string.PNG
