rajatchaple/cubit_3.0/misc/lcd_screens_builder/screens/LCD_screeens/menu_linear_px.PNG

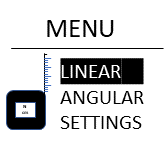
misc/lcd_screens_builder/screens/LCD_screeens/menu_linear_px.PNG
