rajatchaple/cubit_3.0/misc/lcd_screens_builder/screens/LCD_screeens/menu_settings.PNG

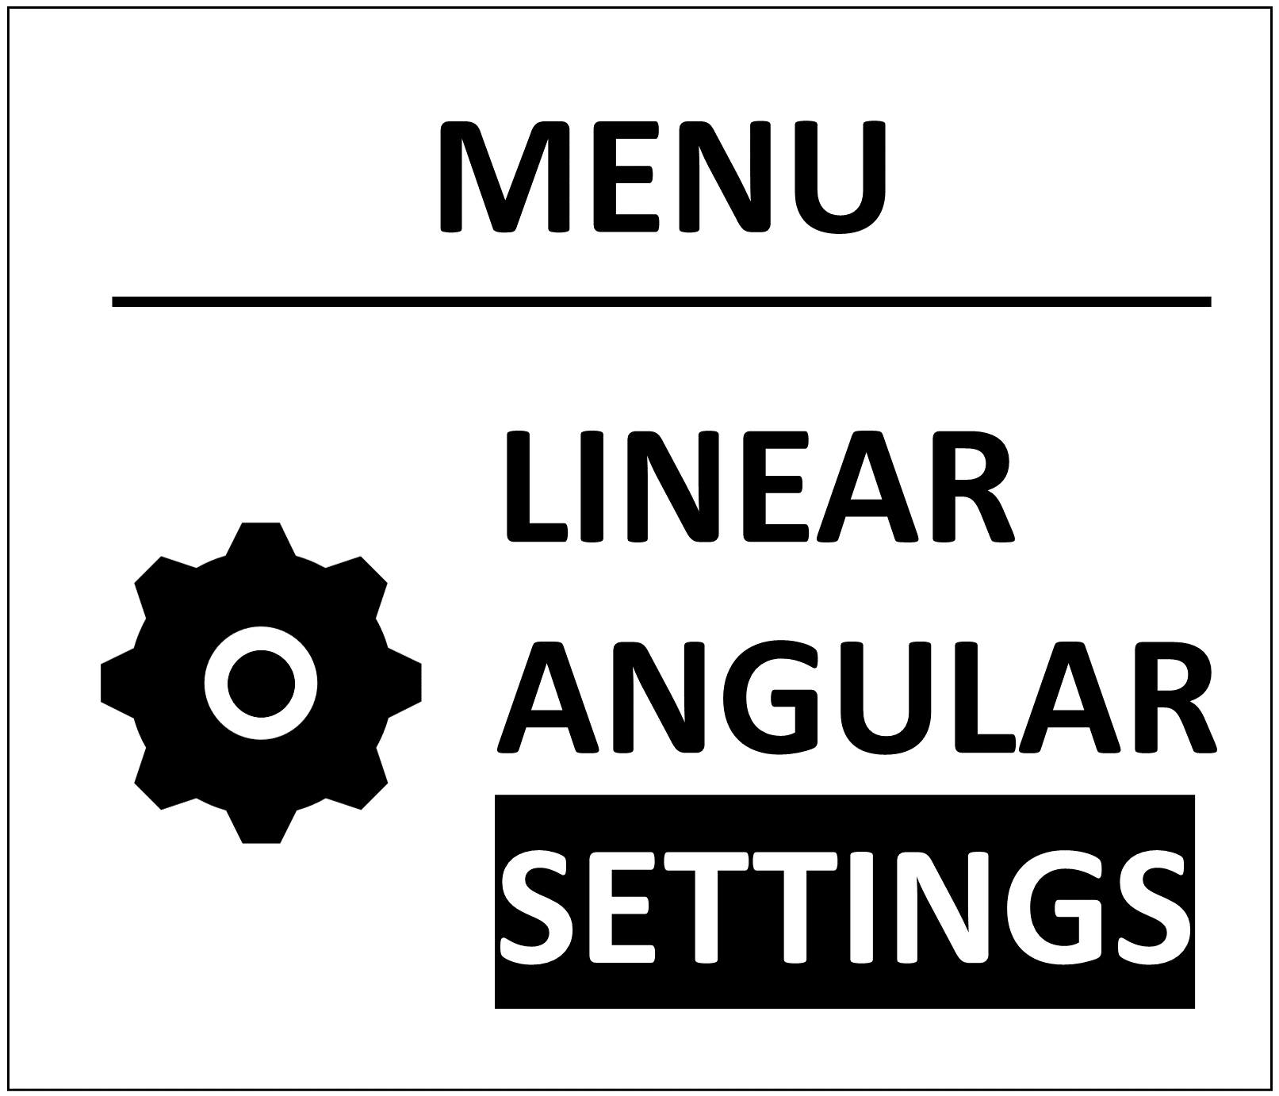
misc/lcd_screens_builder/screens/LCD_screeens/menu_settings.PNG
