rajatchaple/cubit_3.0/misc/lcd_screens_builder/screens/LCD_screeens/settings_unit.PNG

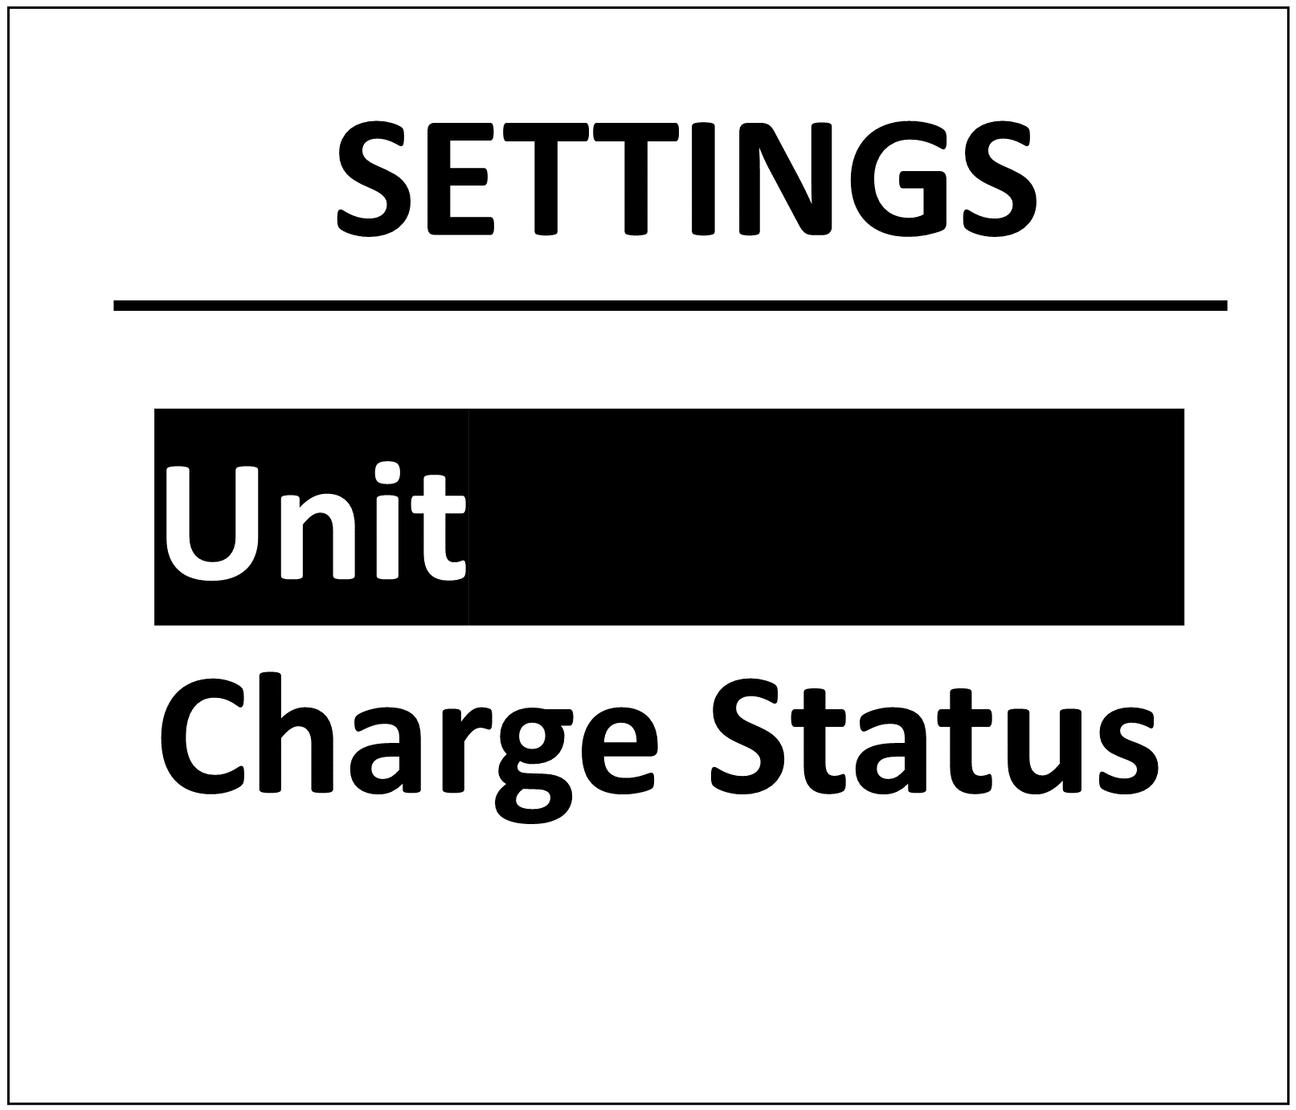
misc/lcd_screens_builder/screens/LCD_screeens/settings_unit.PNG
