rajatchaple/cubit_3.0/misc/lcd_screens_builder/screens/LCD_screeens/sonic_meas_cm.PNG

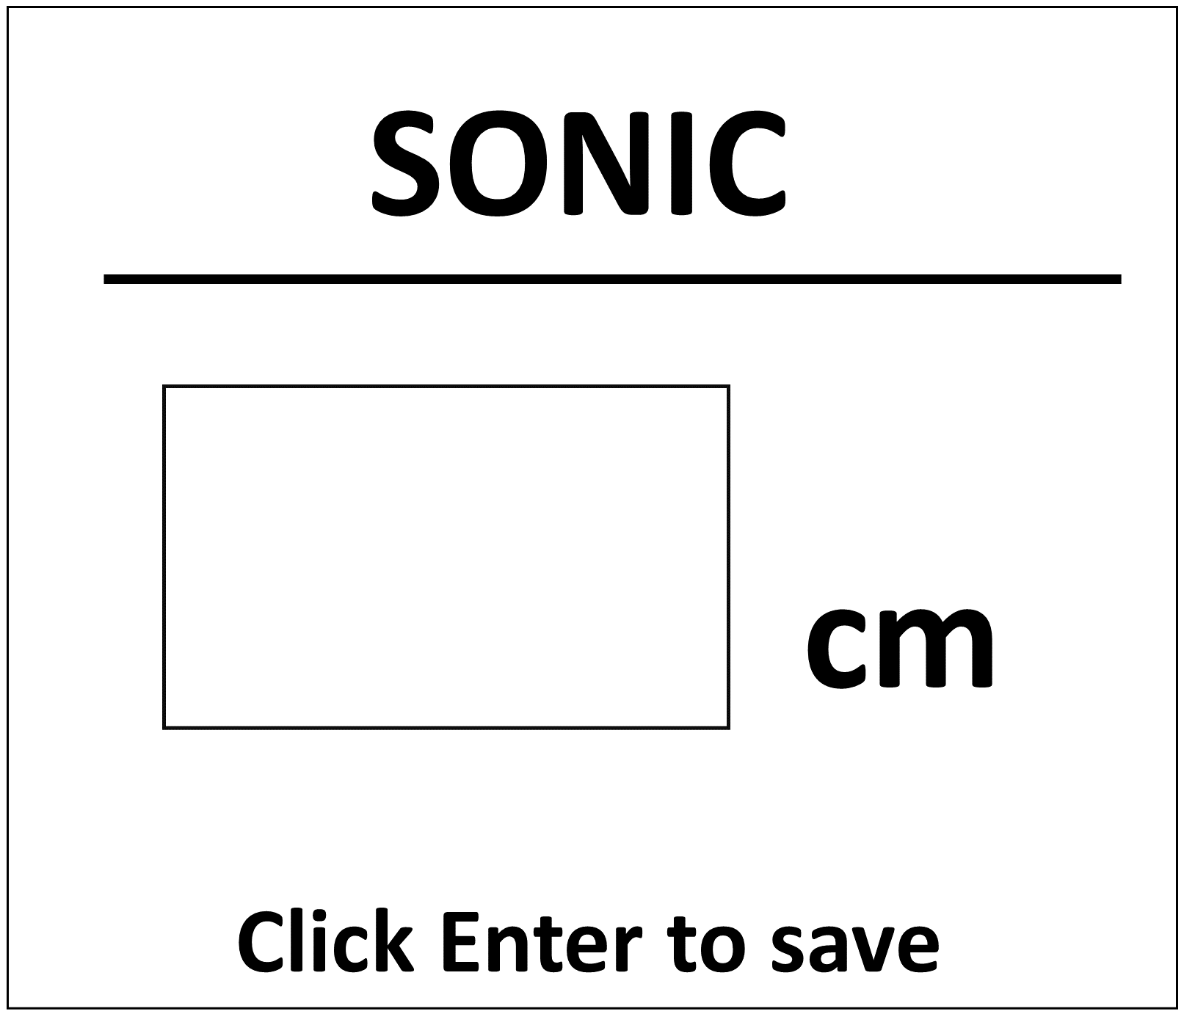
misc/lcd_screens_builder/screens/LCD_screeens/sonic_meas_cm.PNG
