rajatchaple/cubit_3.0/misc/lcd_screens_builder/screens/LCD_screeens/unit_inch.PNG

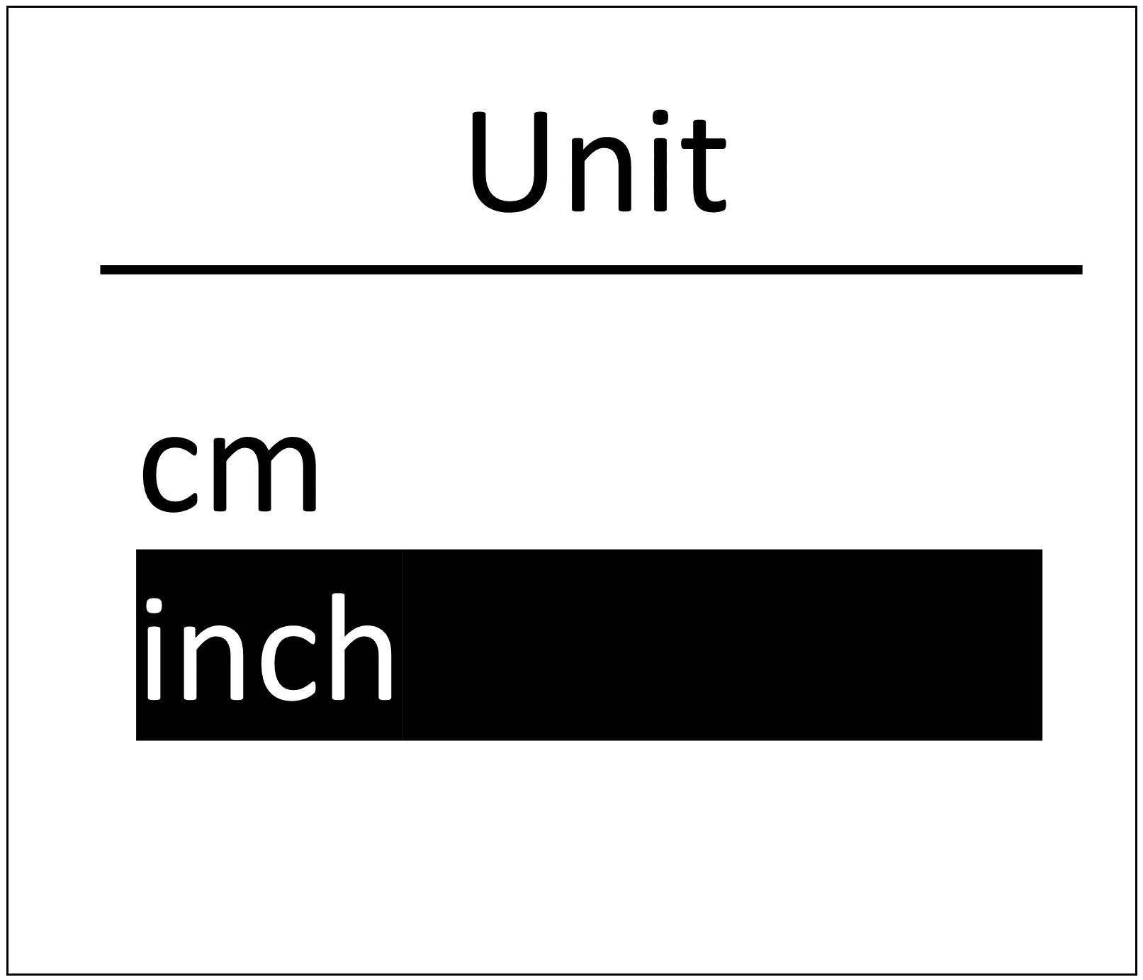
misc/lcd_screens_builder/screens/LCD_screeens/unit_inch.PNG
