rajatchaple/cubit_3.0/misc/lcd_screens_builder/screens/LCD_screeens/wheel_meas_inch.PNG

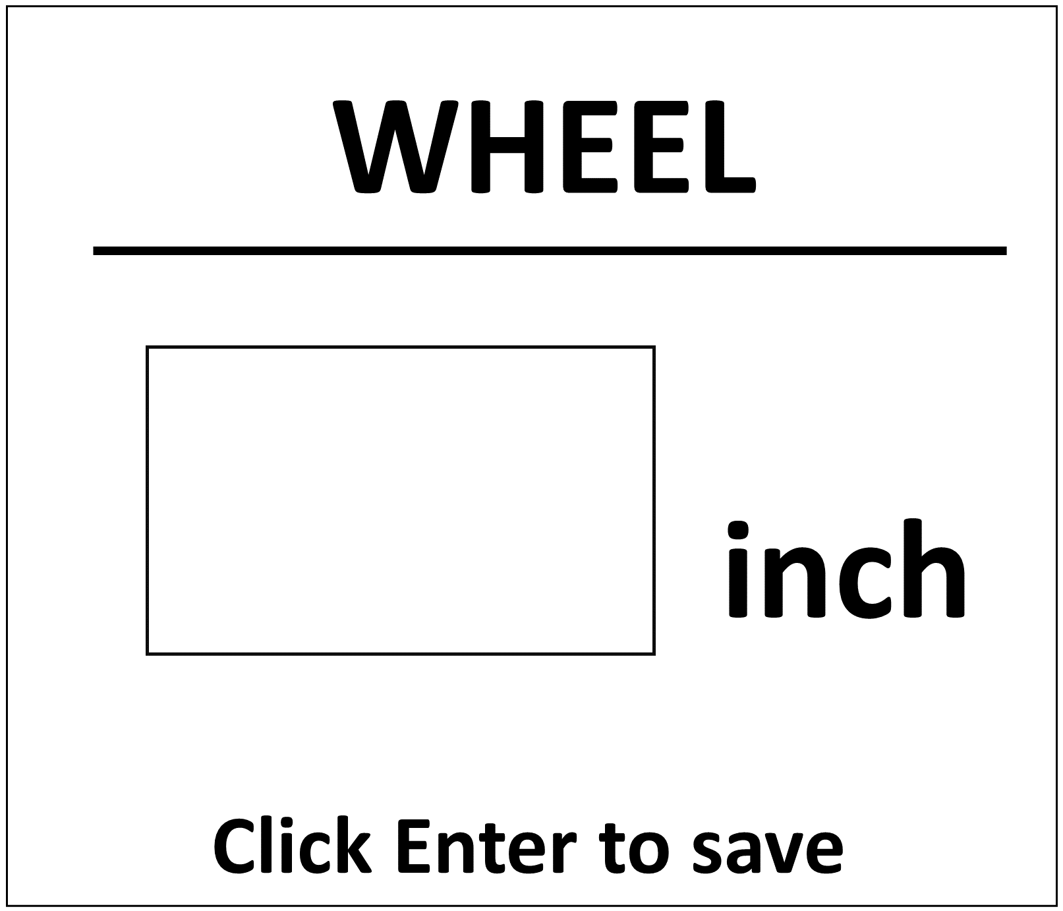
misc/lcd_screens_builder/screens/LCD_screeens/wheel_meas_inch.PNG
