rajatchaple/cubit_3.0/misc/lcd_screens_builder/screens/LCD_screeens_NewAlgo/linear.PNG

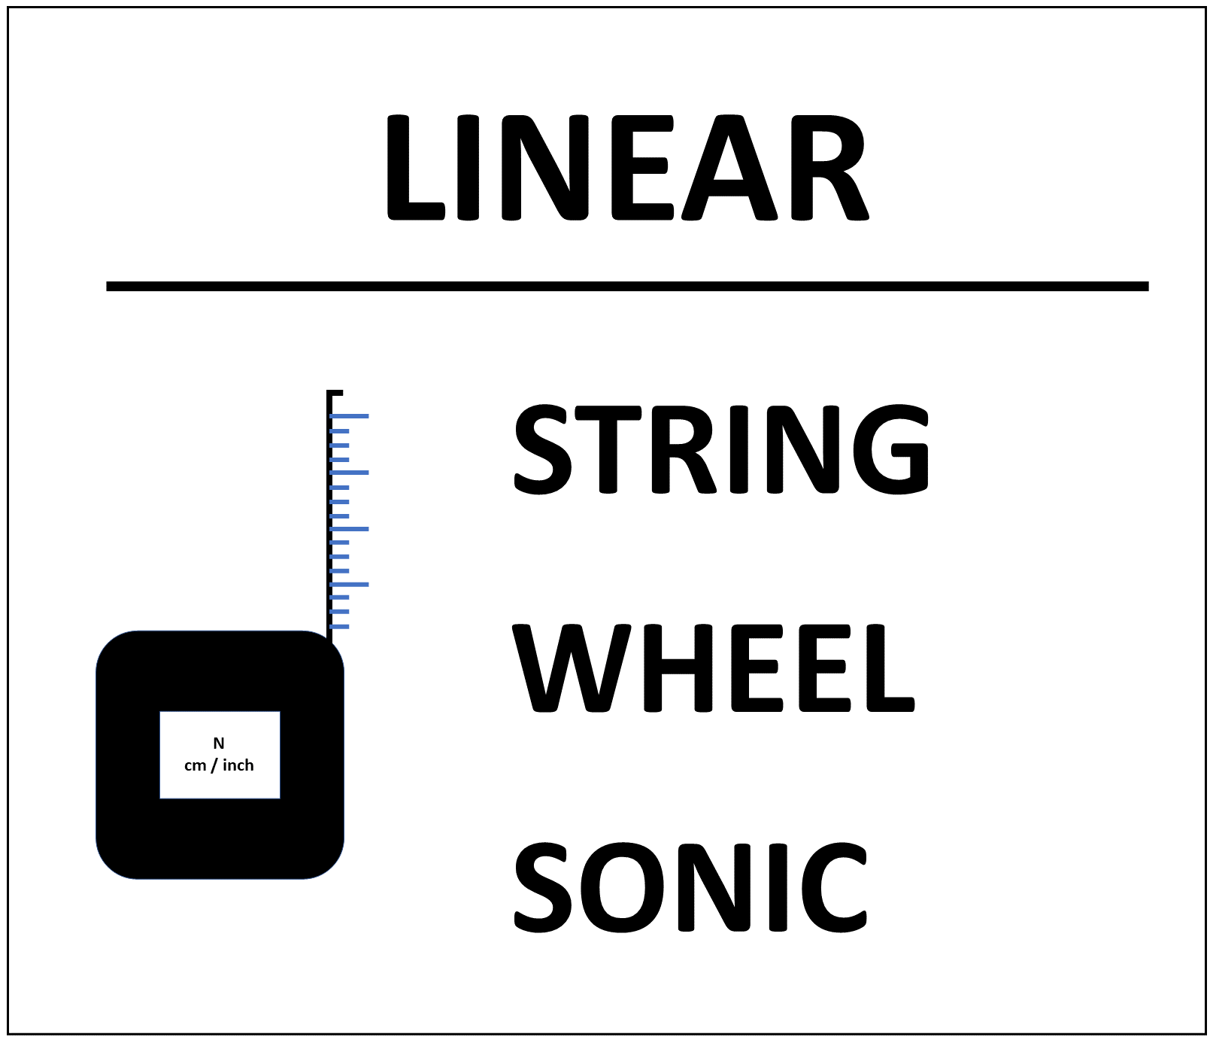
misc/lcd_screens_builder/screens/LCD_screeens_NewAlgo/linear.PNG
