rajatchaple/cubit_3.0/misc/lcd_screens_builder/screens/LCD_screeens_NewAlgo/settings.PNG

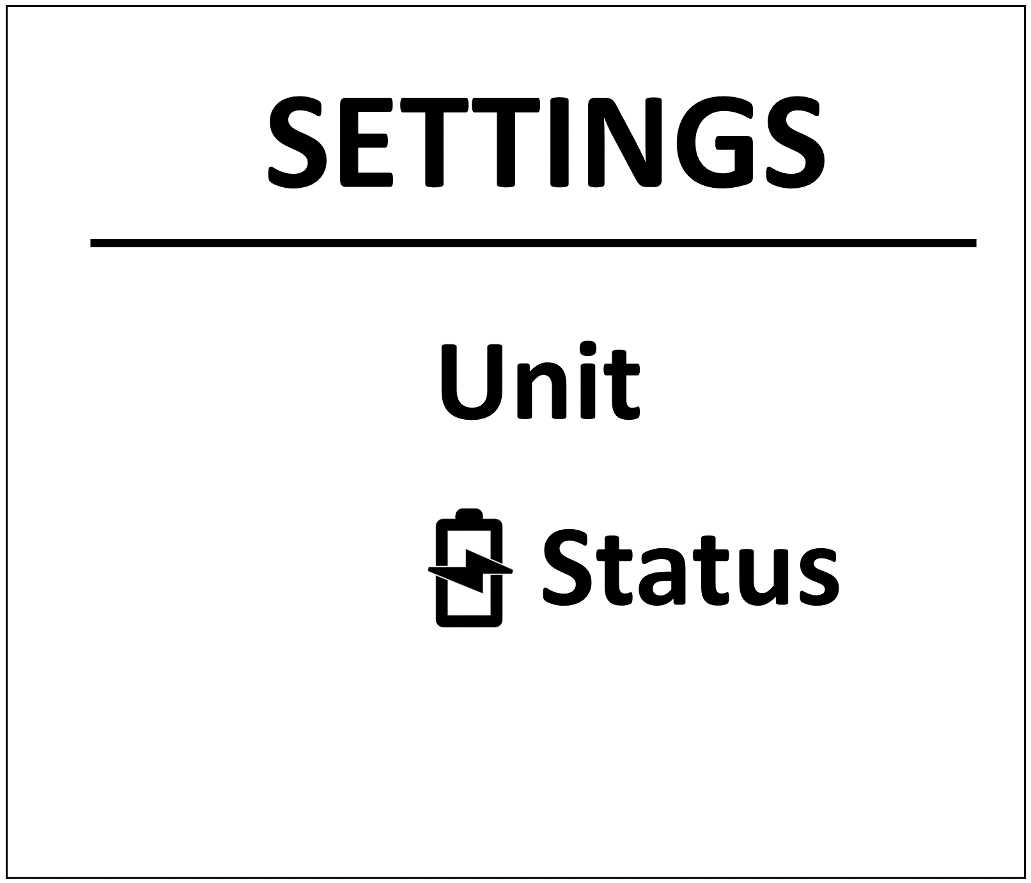
misc/lcd_screens_builder/screens/LCD_screeens_NewAlgo/settings.PNG
