rajatchaple/cubit_3.0/pcba/assembly_helper.pdf

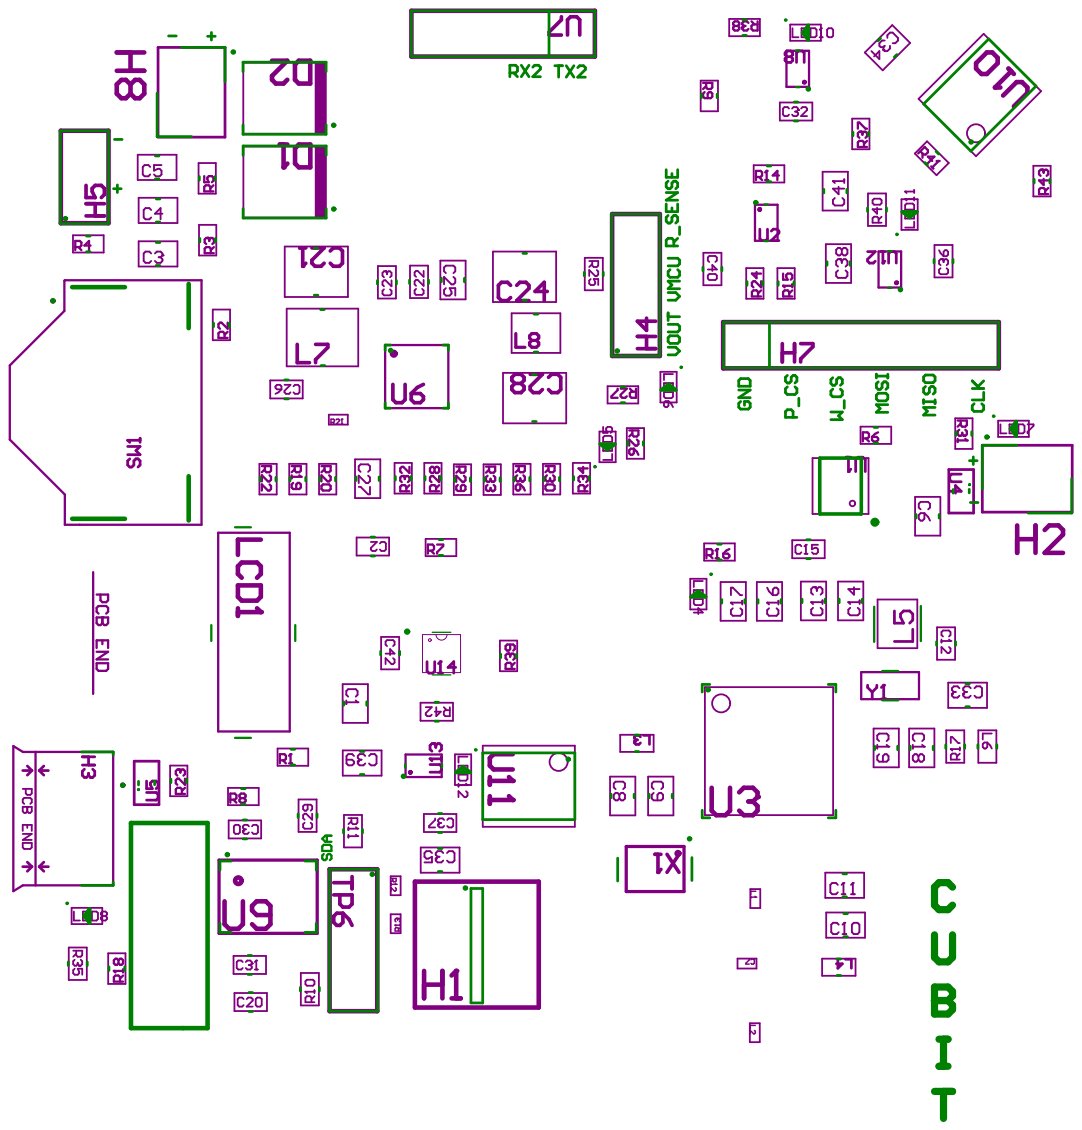
[picture p77: page 1]
