rajatchaple/cubit_3.0/pcb/pcb_assembly.pdf

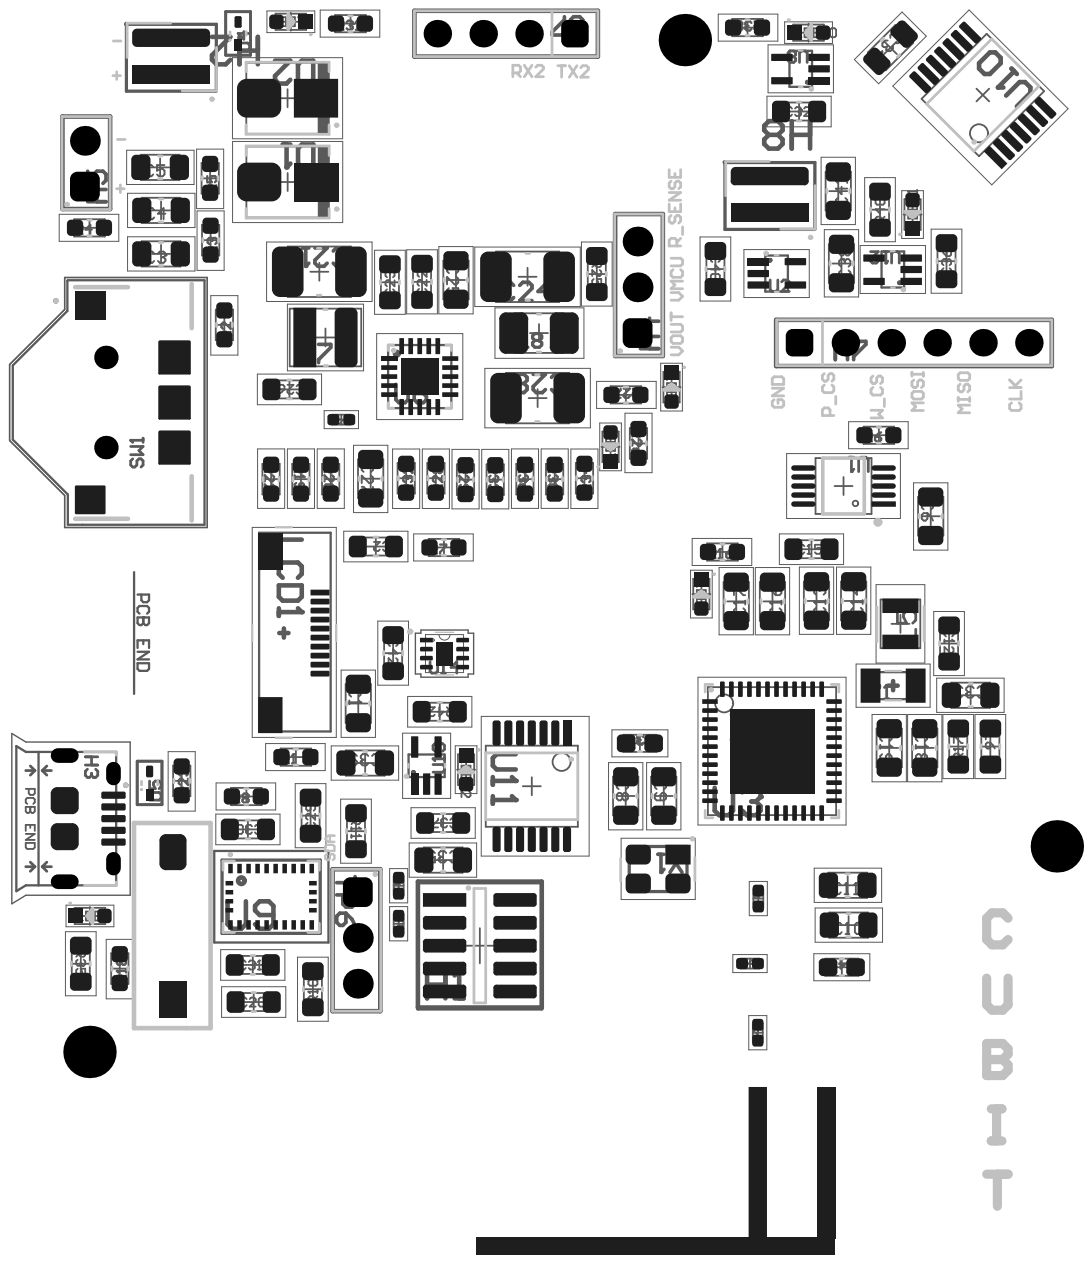
[picture p78: page 1]

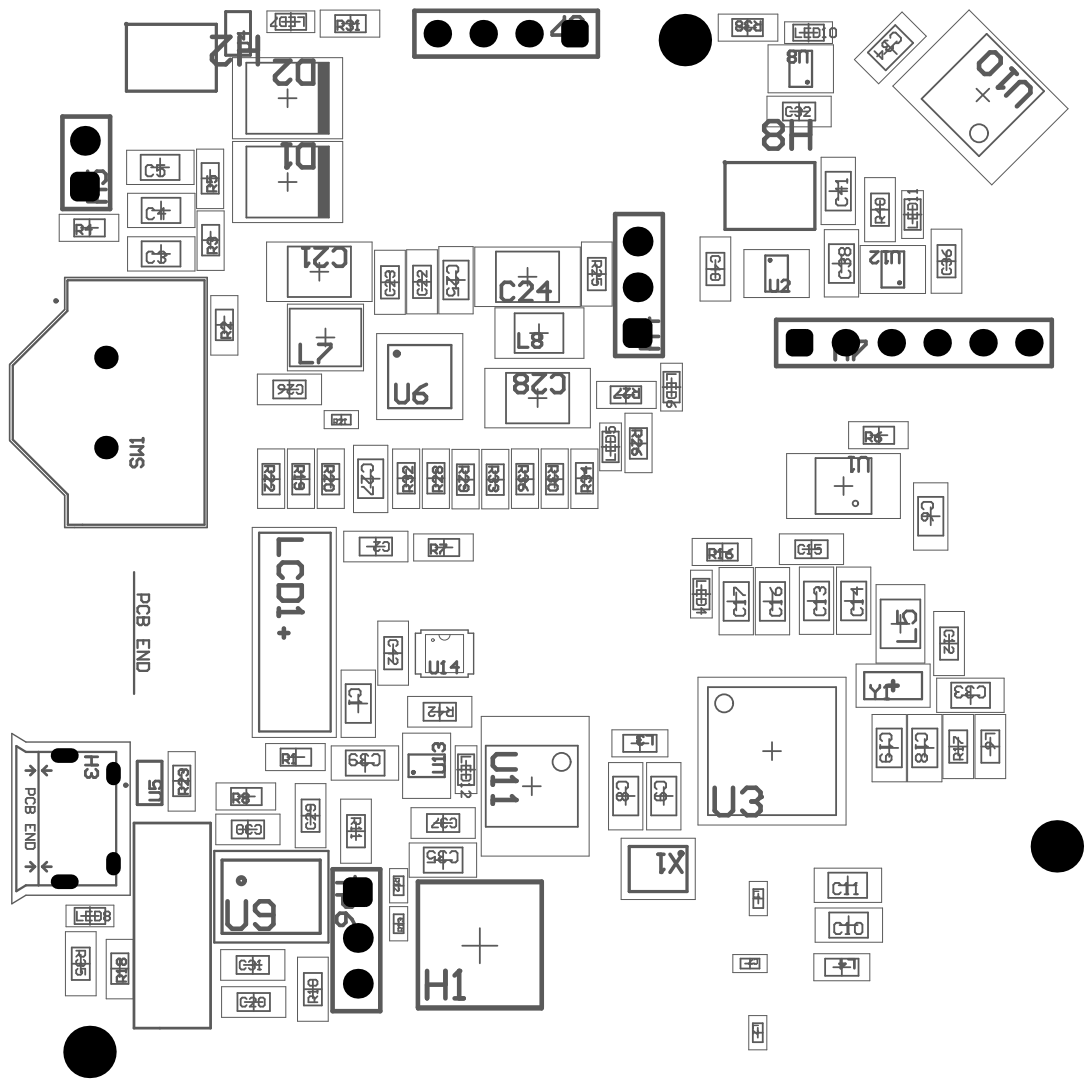
[picture p79: page 2]

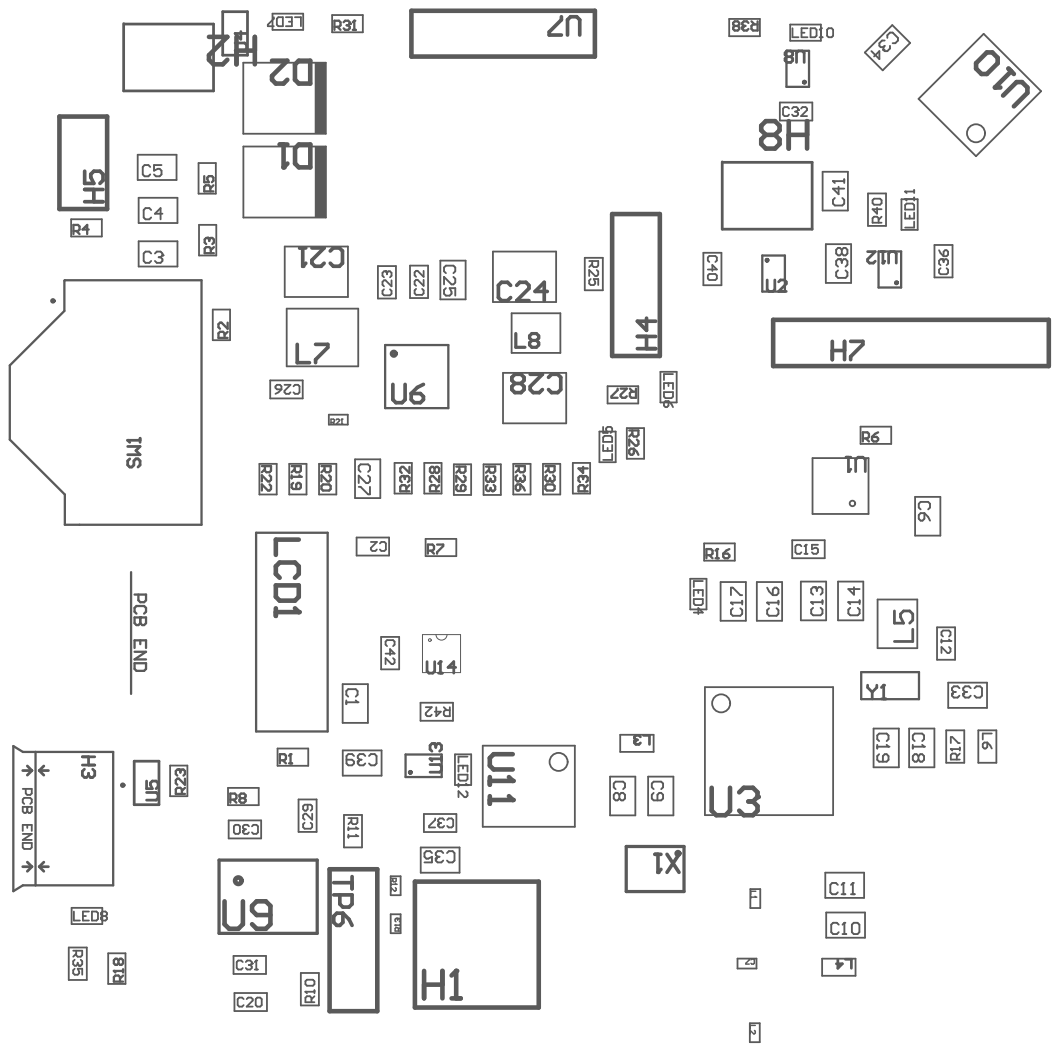
[picture p80: page 5]
