rajatchaple/cubit_3.0/(list of files, drawings)

Other design files:
pcb/Block_Diagram.SchDoc
pcb/Cubit2_0.PcbDoc
pcb/Cubit3_main_pcb.PcbDoc
pcb/Cubit3_solar_panel.PcbDoc
pcb/efr32_ioport.SchDoc
pcb/efr32_lcd_hmi.SchDoc
pcb/efr32_radio_interface.SchDoc
pcb/lpedt_project_board_cubit.PrjPcb
pcb/Mag_Enc_Sensors.SchDoc
pcb/Mag_Enc_Sensors_muxed.SchDoc
pcb/PCB1.PcbDoc
pcb/power_management.SchDoc
pcb/solar_cell.SchDoc
pcb/ultrasonic_imu_sensor.SchDoc
pcb_library/LPEDT_proj_lib.PcbLib
pcb_library/LPEDT_proj_lib.SchLib
pcb_library/Project Outputs for LPEDT_proj_lib/LPEDT_proj_lib/LPEDT_proj_lib.PcbLib
pcb_library/Project Outputs for LPEDT_proj_lib/LPEDT_proj_lib/LPEDT_proj_lib.SchLib
