rajatchaple/cubit_3.0/misc/as5047d_program_otp/as5047d_program_otp.ino

/*
  ConfirgureSensor

  Configure the sensor with advanced parameters.
  This example shows how to activate the UVW output for a 7 pole pairs motor.
  For an advanced list and description of all available parameters, 
  see the manufacturer documentation. All parameters are implemented in this library.

  This example also demostrates how to print debug information.

  Start the terminal with a speed of 9600 Bauds to see the debug information.

  The encoder is connected as follows:
  AS5X47         Arduino Board
    5V <-------------> 5V
   GND <-------------> GND
  MOSI <-------------> MOSI (Pin 11 for Arduino Uno)
  MISO <-------------> MISO (Pin 12 for Arduino Uno)
   SCK <-------------> SCK  (Pin 13 for Arduino Uno)
   CSN <-------------> SS   Arbitrary, Pin 10 in this example.
  See Arduino SPI Reference to see how to connect with other boards.
  https://www.arduino.cc/en/reference/SPI

  Created 18 april 2020
  By Adrien Legrand

  https://github.com/Adrien-Legrand/AS5X47

*/

// Include the library
#include <AS5X47.h>

// Define where the CSN Pin in connected. 
int slaveSelectPin = 10;

// Start connection to the sensor.
AS5X47 as5047d(slaveSelectPin);
Settings1 settings1;
Prog program;
void setup() {
  // Initialize a Serial Communication in order to
  // print the measured angle.
  Serial.begin(9600);

  // Create a structure corresponding to the SETTINGS1 Register
  // See manufacturer documentation for more details.
  

  // Parameters from SETTINGS1 can be set like this:
  // According to manufacturer documentation, UVW_ABI enables UVW output.
  settings1.values.uvw_abi = 0;
  settings1.values.dir = 0;
  settings1.values.factorySetting = 0;
   
  // According to manufacturer documentation, DIR inverts the output signal order.

  // Write settings to the encoder:
  as5047d.writeSettings1(settings1);

  // Same way, parameters from SETTINGS2 Register can be modified:
  Settings2 settings2;
  settings2.values.abires = 4;
  // UVWPP sets the number of pole-pairs to emulate for the UVW output.
//  settings2.values.uvwpp = 7;
 

 as5047d.writeSettings2(settings2);

  
  // This command print the debug information to the Serial port.
  // All registers of the encoder will be read and printed.
  // Note: A Serial communication must be opened with Serial.begin() before.
  as5047d.printDebugString();

  as5047d.writeRegister(PROG_REG, 0x0001);  
  as5047d.writeRegister(PROG_REG, 0x0008);
  while(1){
      ReadDataFrame prog_reg_read = as5047d.readRegister(PROG_REG);
      if(prog_reg_read.values.data == 0x01)
      {
        break;
      }
      else
      {
        Serial.println("waiting for burn");
        delay(5000);
      }
  }

  settings2.values.abires = 0;
  as5047d.writeSettings2(settings2);

  as5047d.writeRegister(PROG_REG, 0x0040);
  as5047d.writeRegister(PROG_REG, 0x0004);


  as5047d.printDebugString();

}

void loop() {
  // Read the measured angle
//  float angle = as5047d.readAngle();

  // Show the measure angle on the Serial Port
//  Serial.println(angle);
//  as5047d.writeSettings1(settings1);
//  as5047d.readRegister(SETTINGS2_REG);
//  as5047d.printDebugString();
  // Wait 1 second (1000 milliseconds) before reading again.
  delay(5000);
}
