rajatchaple/cubit_3.0/software/app.c

/***************************************************************************//**
 * @file
 * @brief Core application logic.
 *******************************************************************************
 * # License
 * <b>Copyright 2020 Silicon Laboratories Inc. www.silabs.com</b>
 *******************************************************************************
 *
 * SPDX-License-Identifier: Zlib
 *
 * The licensor of this software is Silicon Laboratories Inc.
 *
 * This software is provided 'as-is', without any express or implied
 * warranty. In no event will the authors be held liable for any damages
 * arising from the use of this software.
 *
 * Permission is granted to anyone to use this software for any purpose,
 * including commercial applications, and to alter it and redistribute it
 * freely, subject to the following restrictions:
 *
 * 1. The origin of this software must not be misrepresented; you must not
 *    claim that you wrote the original software. If you use this software
 *    in a product, an acknowledgment in the product documentation would be
 *    appreciated but is not required.
 * 2. Altered source versions must be plainly marked as such, and must not be
 *    misrepresented as being the original software.
 * 3. This notice may not be removed or altered from any source distribution.
 *
 * Date:        08-07-2021
 * Author:      Dave Sluiter
 * Description: This code was created by the Silicon Labs application wizard
 *              and started as "Bluetooth - SoC Empty".
 *              It is to be used only for ECEN 5823 "IoT Embedded Firmware".
 *              The MSLA referenced above is in effect.
 *
 ******************************************************************************/


#include "app.h"

// Include logging for this file
#define INCLUDE_LOG_DEBUG 1
#include "src/log.h"
#include "src/ultrasonic.h"
#include "src/lcd.h"
#include "src/lcd_bitmap.h"
#include "src/gpio.h"
#include "src/scheduler.h"
#include "src/lcd_menu.h"

//#define MAGNETIC_ENCODER_SENSOR
//#define IMU_SENSOR
#define ULTRASONIC_SENSOR

bool gpio_inputs_enabled = false;

/*****************************************************************************
 * Application Power Manager callbacks
 *****************************************************************************/
#if defined(SL_CATALOG_POWER_MANAGER_PRESENT)



bool app_is_ok_to_sleep(void)
{

  return APP_IS_OK_TO_SLEEP;

} // app_is_ok_to_sleep()



sl_power_manager_on_isr_exit_t app_sleep_on_isr_exit(void)
{

  return APP_SLEEP_ON_ISR_EXIT;

} // app_sleep_on_isr_exit()



#endif // defined(SL_CATALOG_POWER_MANAGER_PRESENT)

/**************************************************************************//**
 * Application Init.
 *****************************************************************************/
SL_WEAK void app_init(void)
{
  // Put your application 1-time init code here
  // This is called once during start-up.
  // Don't call any Bluetooth API functions until after the boot event.

  sensor_data_t* sensor_data =  get_sensor_data();
  sensor_data->app_init = true;


#if (LOWEST_ENERGY_MODE > 2)
  //LOG_INFO("Lowest Energy mode possible is EM2, changing to EM2");
  LOWEST_ENERGY_MODE = 2;
#endif

#if ((LOWEST_ENERGY_MODE > 0) & (LOWEST_ENERGY_MODE < 3))
  //LOG_INFO("Applying Pwr Mgr requirement of %d\n\r", (int) LOWEST_ENERGY_MODE);
  if(LOWEST_ENERGY_MODE == 2)
    {
      sl_power_manager_remove_em_requirement(SL_POWER_MANAGER_EM1);
      sl_power_manager_add_em_requirement(SL_POWER_MANAGER_EM2);
    }
  else if(LOWEST_ENERGY_MODE == 1)
    sl_power_manager_add_em_requirement(SL_POWER_MANAGER_EM1);
#endif

#ifdef MAGNETIC_ENCODER_SENSOR
  //gpio_init

#elif IMU_SENSOR
  //gpio_init or I2C init

#else //ULTRASONIC_SENSOR
  //gpio_init or UART_init
  //init_usart2();
//  init_leuart();

#endif

  //initialize oscillator
  oscillator_init();






  //initialize GPIO module
  gpioInit();

  //Setting sensors off by default
  gpioMagEncPSetOff();
  gpioMagEncWSetOff();
  gpioUltrasonicSetOff();



  displayInit();


  init_leuart();


  i2c_init();



//  displayUpdate();
  //initialize timer
  mytimer_init();
  imu_turnoff_state_machine(evt_NoEvent);

//  timerWaitUs_polled(100000);
//
//  //enable interrupt for LETIMER0 in NVIC
  NVIC_ClearPendingIRQ(LETIMER0_IRQn);
  NVIC_EnableIRQ(LETIMER0_IRQn);
  NVIC_ClearPendingIRQ(GPIO_EVEN_IRQn);
  NVIC_EnableIRQ(GPIO_EVEN_IRQn);
  NVIC_ClearPendingIRQ(GPIO_ODD_IRQn);
  NVIC_EnableIRQ(GPIO_ODD_IRQn);

  gpio_inputs_enabled = true;
  init_lcd_menu();
//  draw_custom_graphics(CU, NO_RECTANGLE);
//  draw_custom_graphics(LCD_screens_cubit2, NO_RECTANGLE);

//  handle_lcd_menus(evt_NoEvent);
//  draw_custom_graphics(Slide1);
//  draw_custom_graphics_rectangle(Slide2);
//  gpioMagEncWSetOn();
//  gpioMagEncPSetOn();
  while(getNextEvent() == 0)
    {
      uint32_t event = getNextEvent();
    }
}


///*****************************************************************************
// * delayApprox(), private to this file.
// * A value of 3500000 is ~ 1 second. After assignment 1 you can delete or
// * comment out this function. Wait loops are a bad idea in general.
// * We'll discuss how to do this a better way in the next assignment.
// *****************************************************************************/
static void delayApprox(int delay)
{
  volatile int i;

  for (i = 0; i < delay; ) {
      i=i+1;
  }

} // delayApprox()


/**************************************************************************//**
 * Application Process Action.
 *****************************************************************************/
SL_WEAK void app_process_action(void)
{

  // Put your application code here.
  // This is called repeatedly from the main while(1) loop
  // Notice: This function is not passed or has access to Bluetooth stack events.
  //         We will create/use a scheme that is far more energy efficient in
  //         later assignments.

  uint32_t evt;
  sensor_data_t* sensor_data =  get_sensor_data();

//  gpioTestLedSetOff();
//  delayApprox(3500000);
//  gpioTestLedSetOn();
//  delayApprox(3500000);
//  gpioSetDisplayExtcomin(false);


//  gpioTestLedSetOn();

//  gpioMagEncWSetOn();
//  gpioMagEncPSetOn();
//    gpioMagEncWSetOn();



  evt = getNextEvent();         //get event to be executed from scheduler
    if((evt == evt_Button_UP)  ||
        (evt == evt_Button_DOWN)  ||
        (evt == evt_Button_BACK)  ||
        (evt == evt_Button_SELECT))
      {
//        gpioTestLedSetOn();
        handle_lcd_menus(evt);
//        gpioMagEncPSetOff();
      }

    if(sensor_data->is_angular_enabled==true && sensor_data->is_imu_initialization_complete == false)
      {
        if((evt == evt_COMP1)  ||
                (evt == evt_TransferDone)||
                (evt == evt_retry))
          {
            imu_init_state_machine(evt);
          }

      }

    if(sensor_data->is_angular_enabled==true && sensor_data->is_imu_initialization_complete == true)
      {
        if((evt == evt_COMP1)  ||  (evt == evt_TransferDone)||
            (evt == evt_retry))
                  {
                    imu_data_state_machine(evt);
                  }
        else if(evt == evt_start_next_imu_measurement)  //forcing data measurement state machine to restart
          {
            imu_data_state_machine(evt);
          }
      }

  if(sensor_data->is_angular_enabled==false && sensor_data->is_imu_initialization_complete == false)
      {
        if((evt == evt_COMP1)  ||
            (evt == evt_TransferDone) ||
            (evt == evt_retry))
          {
            imu_turnoff_state_machine(evt);
          }

      }


}

/**************************************************************************//**
 * Bluetooth stack event handler.
 * This overrides the dummy weak implementation.
 *
 * @param[in] evt Event coming from the Bluetooth stack.
 *
 * The code here will process events from the Bluetooth stack. This is the only
 * opportunity we will get to act on an event.
 *****************************************************************************/
void sl_bt_on_event(sl_bt_msg_t *evt)
{

  // Just a trick to hide a compiler warning about unused input parameter evt.
  // We will add real functionality here later.
  /*if (evt->header) {
      printf(".\n");
  }*/

  // Some events require responses from our application code,
  // and don’t necessarily advance our state machines.
  // For assignment 5 uncomment the next 2 function calls
  handle_ble_event(evt); // put this code in ble.c/.h

#if DEVICE_IS_BLE_SERVER
  //FOR SERVER
  // sequence through states driven by events
//  temperature_state_machine(evt);    // put this code in scheduler.c/.h

#else
  //FOR CLIENT
  discovery_state_machine(evt);

#endif

} // sl_bt_on_event()
