rajatchaple/cubit_3.0/software/src/lcd_bitmap.c

/* 
* lcd_bitmap.c
*
*  Created on: Aug 09, 2025
*      Author: rajat
*/

#include "lcd_bitmap.h"

const ImageBitmap about = {
    80, 34, about_bitmap
};

const ImageBitmap about_image = {
    184, 176, about_image_bitmap
};

const ImageBitmap about_image_saloni = {
    192, 180, about_image_saloni_bitmap
};

const ImageBitmap about_mini = {
    183, 25, about_mini_bitmap
};

const ImageBitmap angle_icon = {
    32, 30, angle_icon_bitmap
};

const ImageBitmap angle_name = {
    62, 24, angle_name_bitmap
};

const ImageBitmap arc = {
    65, 170, arc_bitmap
};

const ImageBitmap arc1 = {
    50, 170, arc1_bitmap
};

const ImageBitmap arc2 = {
    50, 170, arc2_bitmap
};

const ImageBitmap arc3 = {
    50, 170, arc3_bitmap
};

const ImageBitmap back_icon = {
    33, 29, back_icon_bitmap
};

const ImageBitmap back_icon_selected = {
    33, 29, back_icon_selected_bitmap
};

const ImageBitmap battery_icon = {
    33, 25, battery_icon_bitmap
};

const ImageBitmap bluetooth_icon = {
    16, 27, bluetooth_icon_bitmap
};

const ImageBitmap change_unit = {
    159, 38, change_unit_bitmap
};

const ImageBitmap cm = {
    48, 26, cm_bitmap
};

const ImageBitmap deg = {
    49, 40, deg_bitmap
};

const ImageBitmap dot = {
    15, 15, dot_bitmap
};

const ImageBitmap inch = {
    59, 29, inch_bitmap
};

const ImageBitmap l0 = {
    44, 80, l0_bitmap
};

const ImageBitmap l1 = {
    44, 80, l1_bitmap
};

const ImageBitmap l2 = {
    44, 80, l2_bitmap
};

const ImageBitmap l3 = {
    44, 80, l3_bitmap
};

const ImageBitmap l4 = {
    44, 80, l4_bitmap
};

const ImageBitmap l5 = {
    44, 80, l5_bitmap
};

const ImageBitmap l6 = {
    44, 80, l6_bitmap
};

const ImageBitmap l7 = {
    44, 80, l7_bitmap
};

const ImageBitmap l8 = {
    44, 80, l8_bitmap
};

const ImageBitmap l9 = {
    44, 80, l9_bitmap
};

const ImageBitmap large_angle_icon = {
    95, 70, large_angle_icon_bitmap
};

const ImageBitmap large_pulley_icon = {
    97, 70, large_pulley_icon_bitmap
};

const ImageBitmap large_settings_icon = {
    95, 70, large_settings_icon_bitmap
};

const ImageBitmap large_sonic_icon = {
    95, 70, large_sonic_icon_bitmap
};

const ImageBitmap large_wheel_icon = {
    95, 70, large_wheel_icon_bitmap
};

const ImageBitmap LCD_screens_cubit2 = {
    240, 400, LCD_screens_cubit2_bitmap
};

const ImageBitmap logo = {
    94, 94, logo_bitmap
};

const ImageBitmap logo_mini = {
    133, 31, logo_mini_bitmap
};

const ImageBitmap menu_arrow = {
    40, 30, menu_arrow_bitmap
};

const ImageBitmap menu_frame = {
    240, 400, menu_frame_bitmap
};

const ImageBitmap pulley_icon = {
    40, 30, pulley_icon_bitmap
};

const ImageBitmap pulley_name = {
    74, 24, pulley_name_bitmap
};

const ImageBitmap s0 = {
    20, 36, s0_bitmap
};

const ImageBitmap s1 = {
    20, 36, s1_bitmap
};

const ImageBitmap s2 = {
    20, 36, s2_bitmap
};

const ImageBitmap s3 = {
    20, 36, s3_bitmap
};

const ImageBitmap s4 = {
    20, 36, s4_bitmap
};

const ImageBitmap s5 = {
    20, 36, s5_bitmap
};

const ImageBitmap s6 = {
    20, 36, s6_bitmap
};

const ImageBitmap s7 = {
    20, 36, s7_bitmap
};

const ImageBitmap s8 = {
    20, 36, s8_bitmap
};

const ImageBitmap s9 = {
    20, 36, s9_bitmap
};

const ImageBitmap settings_icon = {
    35, 30, settings_icon_bitmap
};

const ImageBitmap settings_name = {
    117, 24, settings_name_bitmap
};

const ImageBitmap sonic_icon = {
    35, 30, sonic_icon_bitmap
};

const ImageBitmap sonic_name = {
    63, 24, sonic_name_bitmap
};

const ImageBitmap unit = {
    56, 33, unit_bitmap
};

const ImageBitmap wheel_icon = {
    40, 30, wheel_icon_bitmap
};

const ImageBitmap wheel_name = {
    67, 24, wheel_name_bitmap
};

const ImageBitmap large_digits[] = { l0, l1, l2, l3, l4, l5, l6, l7, l8, l9 };
const ImageBitmap small_digits[] = { s0, s1, s2, s3, s4, s5, s6, s7, s8, s9 };
