rajatchaple/cubit_3.0/(commit log)

2025-04-21 mechanical assembly draft completed
    [BOM_cubit2.xlsx, Block_Diagram.SchDoc, Component_Library.xlsx, Cubit2_0.PcbDoc, Cubit2_pcb_main.step, Cubit2_solar_panel.step, Cubit3_main_pcb.PcbDoc, Cubit3_main_pcb.SLDPRT]
2025-08-10 cubit 3 screens updated as per assembly
    [Cubit2_pcb_main.step, Cubit2_solar_panel.step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]
