rajatchaple/cubit_3.0/(notices)

Notices in the files:
pcb_library/component_3D_steps/PTS636SL43SMTRLFS.stp:
author */ ('License CC BY-ND 4.0'),
